dan-leo/digital-power-supply/README.md

# digital-power-supply
This is a low noise digital power supply. It is custom built for the purposes of the Electronic Design 344 course held at Stellenbosch University.
