dan-leo/digital-power-supply/wiki/Edesign344Project18361137.pdf

# 10/1/2016 Linear Power- supply Design

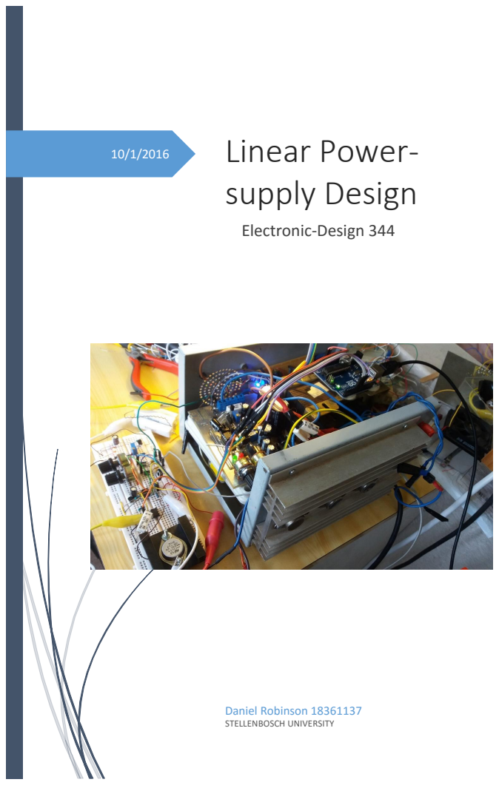
[picture p7: page 1]
Electronic-Design 344; Daniel Robinson 18361137; STELLENBOSCH UNIVERSITY

1-2

## Declaration

I, the undersigned, hereby declare that the work contained in this report is my own original work and unless otherwise stated.

Signature: |
D. Robinson
Date: |

1-3

## Abstract

This report will document the design, analysis, measurement and correlation between theoretical, simulated and measured values of a power supply which can be digitally interfaced, per desired specifications. Due to the limited time frame, and the amateur experience, it is indeed a simple power supply; also, meant to educate the designer.

The report will document all the obstacles, errors and choices made, until a relatively stable conclusion is reached, throughout the paper.

1-4

## Summary

This project was built using a huge 160W transformer in mind, but due to the large currents it damaged the PCB beyond repair within the remaining time left for the project. In fact, it was the morning of the demo that it happened. A quick simple circuit was breadboarded and demonstrated later that day. Both designs will be discussed throughout the paper.

One highlight was sourcing 19A through that 160W transformer.

This project, including report, spice code and CAD files can be found on https://github.com/daniel-leonard-robinson/digital-power-supply .

1-5

## Table of Contents

Declaration | 1-2
Abstract | 1-3
Summary | 1-4
1 | List of Abbreviations | 1-9
2 | Introduction | 2-10
3 | Problem Statement | 3-11
4 | Literature Study: System | 4-12
5 | System Design | 5-12
5.1 | Transformers | 5-12
5.1.1 | Literature Study | 5-12
5.1.2 | Design | 5-12
5.1.3 | Analysis | 5-15
5.1.4 | Building the circuit | 5-16
5.1.5 | Measurements | 5-17
5.1.6 | Comparison of theoretical and measured values | 5-17
5.1.7 | Conclusion and recommendations | 5-18
5.2 | Rectifiers & Capacitor Banks | 5-19
5.2.1 | Literature Study | 5-19
5.2.2 | Design | 5-19
5.2.3 | Analysis | 5-20
5.2.4 | Building the circuit | 5-20
5.2.5 | Measurements | 5-22
5.2.6 | Comparison of theoretical and measured values | 5-22
5.2.7 | Conclusion and recommendation | 5-23
5.3 | Zener Constant-Voltage Reference | 5-23
5.3.1 | Literature Study | 5-23

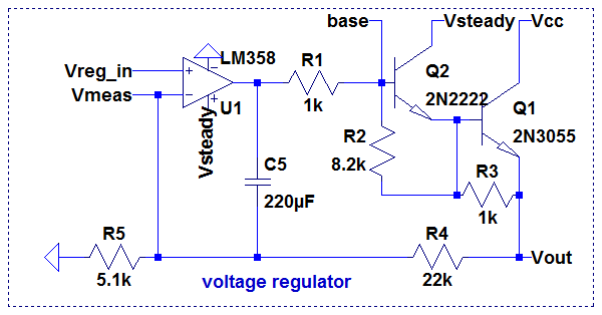
[picture p8: figure]

1-6

5.3.2 | Design | 5-24
5.3.3 | Analysis | 5-24
5.3.4 | Building the circuit | 5-25
5.3.5 | Measurements | 5-25
5.3.6 | Comparison of theoretical and measured values | 5-25
5.3.7 | Conclusion and recommendation | 5-25
Literature Study | 5-25
5.4 | Outboard Pass transistor stage | 5-25
5.4.1 | Literature Study | 5-25
5.4.2 | Design | 5-26
5.4.3 | Analysis | 5-28
5.4.4 | Building the circuit | 5-29
5.4.5 | Measurements | 5-30
5.4.6 | Comparison of theoretical and measured values | 5-30
5.4.7 | Conclusion and recommendation | 5-30
5.5 | Voltage Regulator | 5-30
5.5.1 | Literature Study | 5-30
5.5.2 | Design

5-31

5.5.3 Analysis | 5-32

1-7

5.5.4 | Building the circuit | 5-32
5.5.5 | Measurements | 5-32
5.5.6 | Comparison of theoretical and measured values | 5-33
5.5.7 | Conclusion and recommendation | 5-33
5.6 | Current limiter | 5-34
5.6.1 | Literature Study | 5-34
5.6.2 | Design | 5-34
5.6.3 | Analysis | 5-36
5.6.4 | Building the circuit | 5-36
5.6.5 | Measurements | 5-37
5.6.6 | Comparison of theoretical and measured values | 5-37
5.6.7 | Conclusion and recommendation | 5-38
6 | Circuit Integration (Analogue) | 6-39
6.1 | Final System Measurements | 6-41
6.2 | Interpretation of Results | 6-41
7 | Software Design | 7-43
7.1 | Purpose & Requirement | 7-43
7.2 | Software Literature | 7-43
7.3 | Software Development Approach | 7-44
7.4 | Instructions | 7-45
7.4.1 | Voltage Gain | 7-45
7.4.2 | Current Gain (transconductance) | 7-45
7.5 | Software Extras | 7-46
7.5.1 | Control System | 7-46
7.5.2 | Battery charging profiles | 7-47
7.5.3 | Cellular connectivity | 7-50
7.6 | Arduino Interface | 7-50
7.6.1 | Inputs (PWM RC filters) | 7-50
7.6.2 | Outputs | 7-52

1-8

7.7 | Complete System Integration (+digital) | 7-54
7.7.1 | Interpretation of results in Appendix A | 7-56
8 | Appendix A: Measured Demonstration Results | 8-56
9 | Appendix B: Circuit Diagram | 9-58
10 | Appendix C: PCB Layout | 10-60
11 | Appendix D: Photo of Circuit | 11-61
12 | Appendix E: Calculations | 12-63
12.1 | Appendix E.1: Transformers | 12-63
12.2 | Appendix E.2: Rectifiers & Capacitor Banks | 12-63
12.3 | Appendix E.3: Zener Constant Voltage Reference | 12-63
12.4 | Appendix E.4: Pass Output Stage | 12-63
12.5 | Appendix E.5: Voltage Regulator | 12-63
12.6 | Appendix E.6: Current Limiter | 12-63
12.7 | Appendix E.7: Arduino Interface | 12-63
12.7.1 PWM filter | 12-63
13 | Appendix F: Source code | 13-65
14 | Appendix G: Extra information | 14-77
14.1 | Extra Hardware Features | 14-77
14.1.1 Battery charging profiles | 14-77
15 | Final Conclusion | 15-77
16 | Figures | 16-77
17 | Glossary | 17-80
18 | Index | 18-80
19 | Bibliography | 19-81

1-9

1 | List of Abbreviations
| • PCB – Printed Circuit Board • SMPS – Switched Mode Power Supplies • NiMH – Nickel-Metal Hydride • Pb – Lead • Li – Lithium • RC – Resistor Capacitor • LPF – Low Pass Filters • PSRR - Power Supply Rejection Ratio

2-10

2 | Introduction
| The aim of this project is to build a power supply to satisfy a client’s requirements.
It must have minimal ripple, as well as constant voltage and current mode. It must also be built using analogue components such as op amps, but not ICs such as voltage regulators (e.g. LM317). There are components provided, but it is up to the designer what they use. They may use components provided by the Stellenbosch University store room, or source their own.
| The power supply is the heart of all electronic devices. An understanding is crucial
in understanding the non-linear effects, responses and ways a power supply can affect a product. Power supply design is very broad, and two directions which benefit relatively equally, albeit differently, from a project like this, are either ultra-low powered, or high powered applications.
| Lastly, there will be a limited time frame to complete this project, which simulates
industry conditions, and is mostly meant to educate the designer him/herself, by overcoming pitfalls the designer is mostly unprepared for. Such pitfalls one really only overcomes through experience, and it is a good precursor to a future in the industrial or academic world.

Design -> Analyse -> Build -> Measure -> Repeat

3-11

## 3 Problem Statement

The design of the power supply will overcome the following problems:
| • Low ripple • It is required to provide 1A at 12V • It is required to provide 500mA at 14V • It is required to measure and set voltages/currents via a PC. • (Optional) Charge NiH and Pb batteries using software profiles • The op amps can output max Vcc – 1.5V • The output stage pass transistors have a voltage drop across them (perhaps 1V). • All in all, there is about a 2-3V drop to regulate unregulated voltage after the diode bridge. • Non-linear effects of op amps, transistors, Zeners etc. must be considered

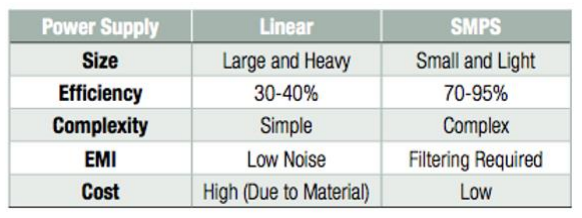
[picture p9: figure]

5-12

4 | Literature Study: System
| Power supplies are used all over the world. There are many different kinds. Besides
varying power ratings, they are divided into mainly two fields: linear and switched mode power supplies, with the latter being more complicated. A note on SMPS: due to its frequency selective behaviour in choosing output current for an arbitrary load, it is quite efficient, and requires much smaller transformers as opposed to linear power supplies.
| On the other hand, SMPS are very noisy in radio applications, and rather require
linear power supplies.

## 5 System Design

This will include the design, analysis, measurements and comparisons of theory and results as well as an introductory literature study.

5.1 | Transformers
5.1.1 | Literature Study

“Michael Bay invented transformers in 1903. “

5.1.2 Design

There are two transformers provided: a 230V primary to 15V 1A secondary transformer, as well as a dual secondary 9V 400mA transformer. There are another two transformers that the designer had available: a 16V dual secondary (unknown current rating), and a 20V 8A secondary transformer.

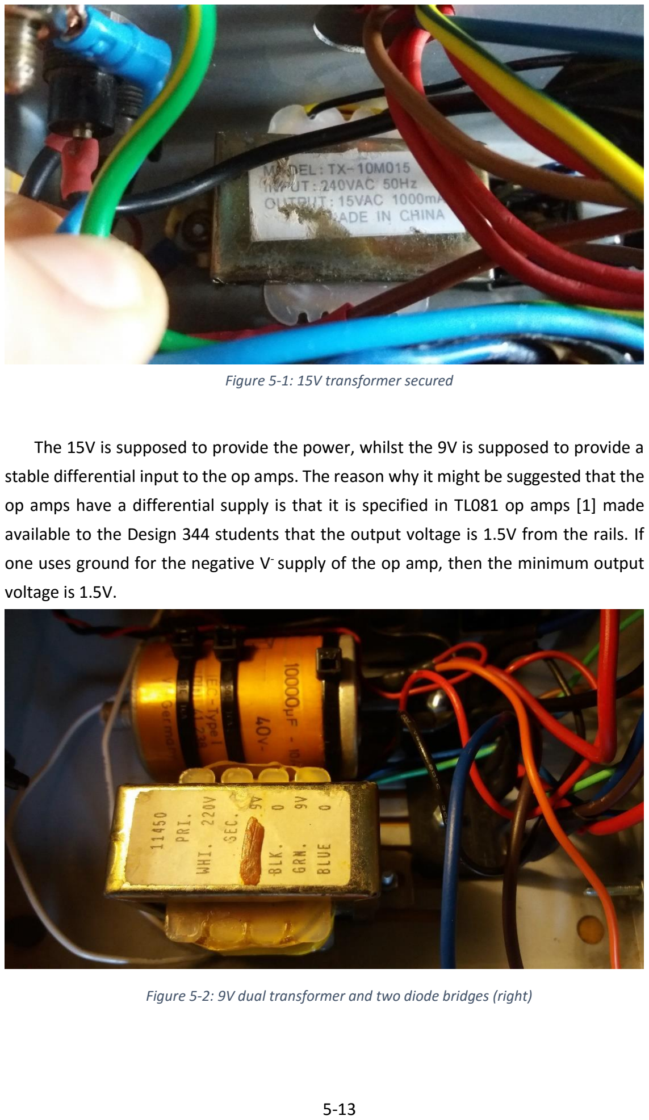
[picture p10: page 13]

5-13

Figure 5-1: 15V transformer secured

The 15V is supposed to provide the power, whilst the 9V is supposed to provide a stable differential input to the op amps. The reason why it might be suggested that the op amps have a differential supply is that it is specified in TL081 op amps [1] made available to the Design 344 students that the output voltage is 1.5V from the rails. If one uses ground for the negative V-supply of the op amp, then the minimum output voltage is 1.5V.

Figure 5-2: 9V dual transformer and two diode bridges (right)

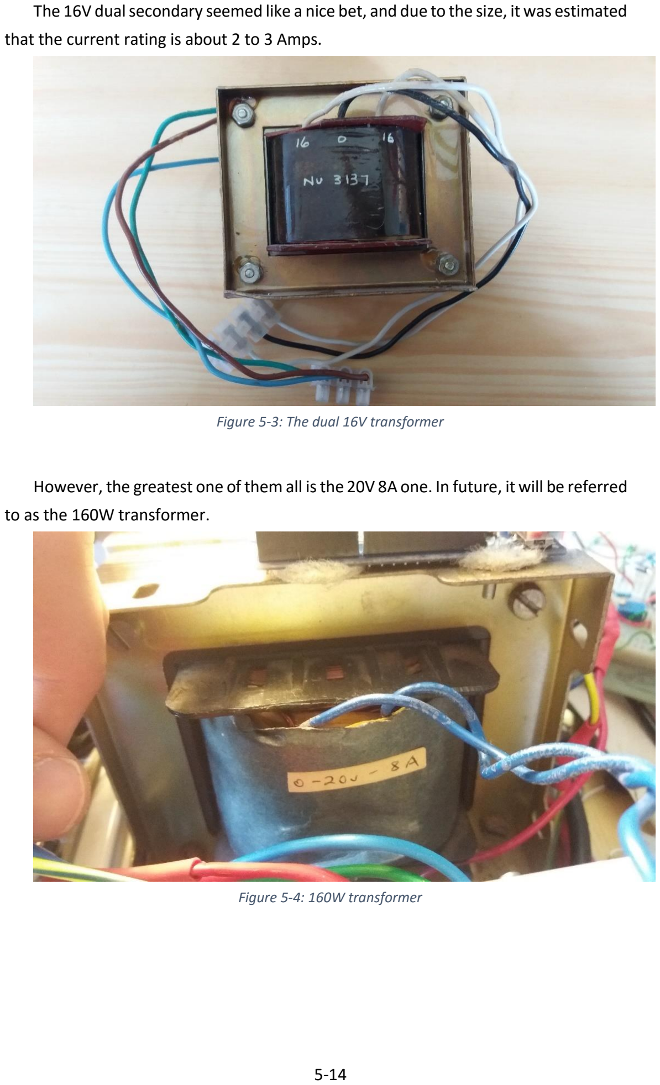
[picture p11: page 14]

5-14

The 16V dual secondary seemed like a nice bet, and due to the size, it was estimated that the current rating is about 2 to 3 Amps.

Figure 5-3: The dual 16V transformer

However, the greatest one of them all is the 20V 8A one. In future, it will be referred to as the 160W transformer.

Figure 5-4: 160W transformer

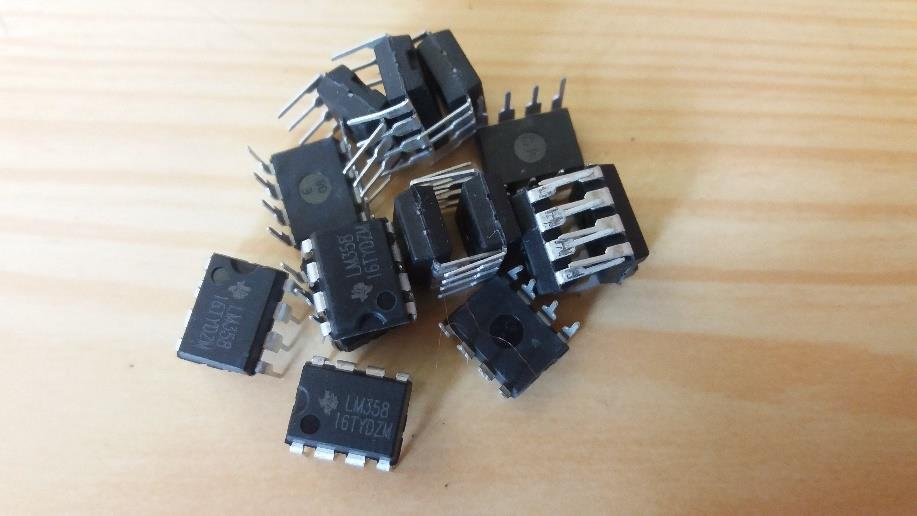
[picture p12: figure]
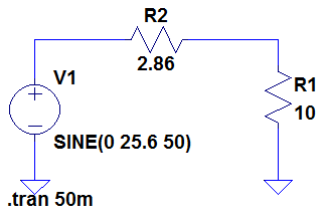
[picture p13: figure]

5-15

It was planned that dual LM358 op amps would be used since a bountiful supply was available, and they could output 0V in single rail mode ¹ when sinking low currents. The goal is just to design a power supply that requires only 1 rail to fully make use of the extra voltage overhead. Then one also only needs one transformer in the end.

Figure 5-5: Couple of dual LM358s

5.1.3 Analysis

When the 15V transformer voltages were measured under load, it was discovered that Rseries was about 2.86 ohms. See Appendix E.1
Using this information, a spice model was built to see what kind of voltages to expect under 1 Amp load.

Figure 5-6: simple thevinin equivalent 15V transformer model.

1
Single rail mode means a supply voltage of 0 to Vcc, not -Vcc/2 to Vcc/2

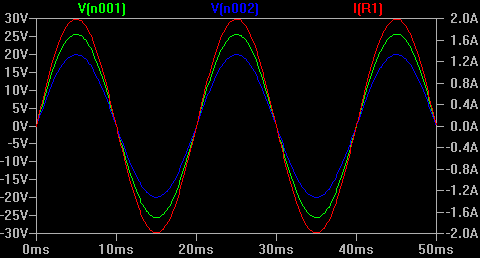
[picture p14: figure]
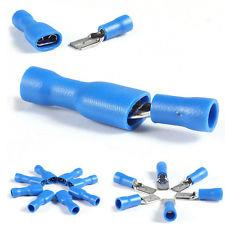
[picture p15: figure]

5-16

Figure 5-7: voltage drop after series resistance (blue), current (red)

With an average current of 1A, we can see here that the peak voltage only drops about 5V. Unfortunately this is not very helpful without the capacitive load as well, since one does not yet know by how much the voltage will drop in the end.

5.1.4 Building the circuit

Crimp connectors were used for easy “hot swapping” of transformers.

Figure 8: Crimp connectors

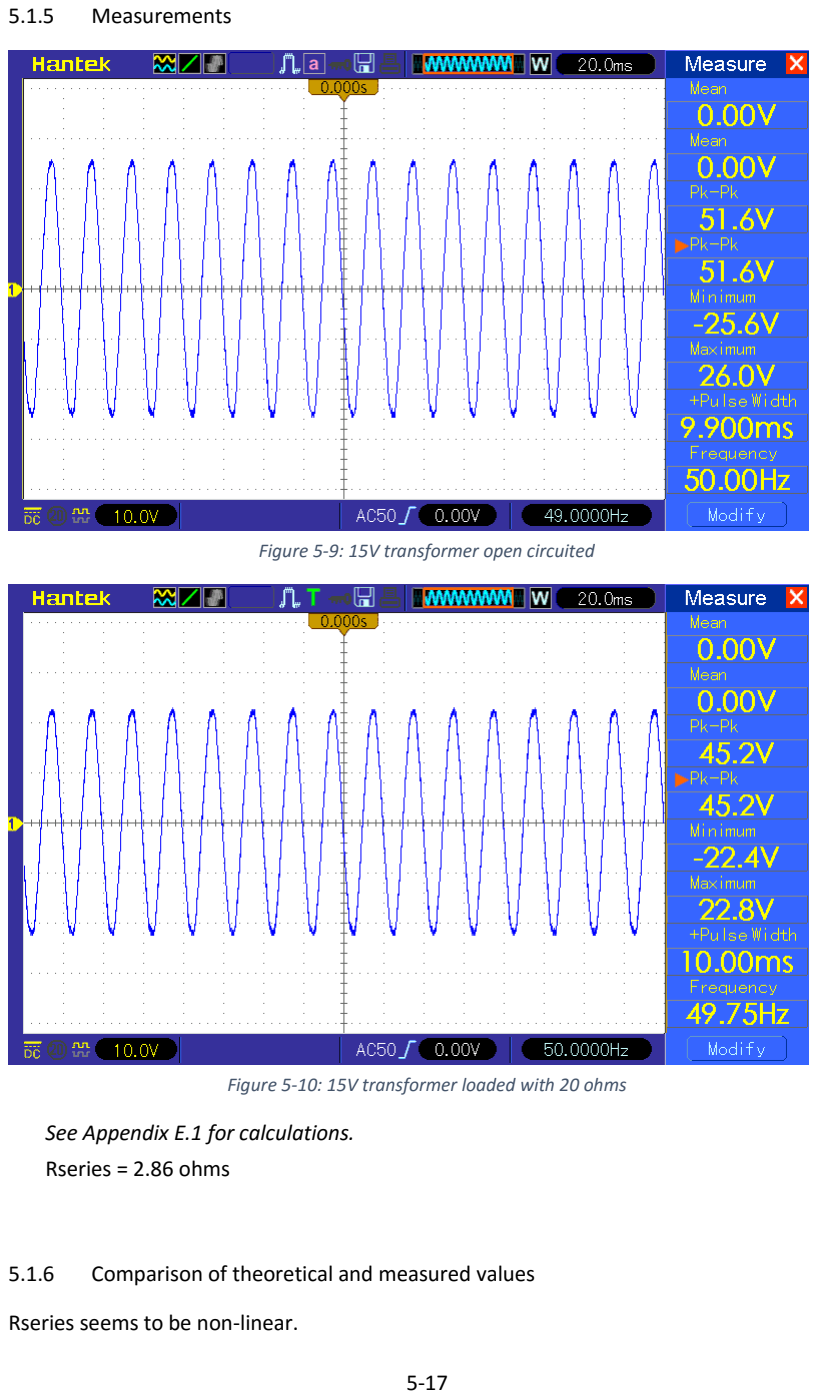
[picture p16: page 17]

5-17

5.1.5 Measurements

Figure 5-9: 15V transformer open circuited

Figure 5-10: 15V transformer loaded with 20 ohms

See Appendix E.1 for calculations. Rseries = 2.86 ohms

5.1.6 Comparison of theoretical and measured values

Rseries seems to be non-linear.

5-18

5.1.7 Conclusion and recommendations

Of course, as a recommendation is to actually use a bigger transformer. Well, the plan is indeed to be able to utilise both transformers interchancheably.


5-19

5.2 | Rectifiers & Capacitor Banks
5.2.1 | Literature Study

“Today, tomorrow, together we’ll open a capacitor bank.”

5.2.2 Design

The Taylor series approximated ripple equation gives the voltage ripple over the capacitors when the max current is flowing through the diode bridge and depends on the frequency of the mains, and the capacitance used.

| Vr =

Imax
2 ∙ f ∙ C
Two 10mF 35V capacitors were available. With Imax = 1A, f = 50Hz and C = 20mF.
| Vr = 500mV

Figure 5-11: Bridge and capacitors

A steadier voltage reference was used to supply power to everything except the pass transistor. With the estimated power usage to be about 100mA, the steadier voltage supply would have about 50mV of ripple. Besides current not being able to escape through the blocking diode, it is steadier because less current discharges out of the capacitors, and relates to the equation:
dv
dt = i
C

⁄

With less current, and more capacitance, the change in voltage is less.

Luckily, the whole purpose of a voltage regulator is to regulate the input. Therefore, the op amp can compensate for this lesser ripple by having a stable Zener reference.

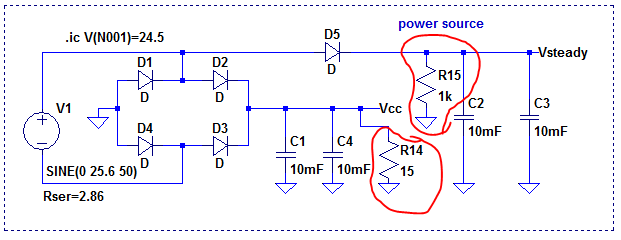
[picture p17: figure]
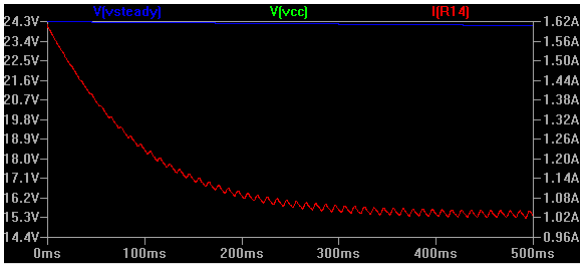
[picture p18: figure]

5-20

5.2.3 Analysis

Here is a circuit to display the two different voltages that will be used to power the circuit.

Figure 5-12: 15 ohm load, and 1k represents the load of the rest of circuit

Figure 5-13: Diode + capacitor bank under load.

It appears to be a neat trick. The voltage tapped off before the diode bridge seems to be much higher than the voltage used to power the load.

5.2.4 Building the circuit

The circuit was built with a diode bridge which accepts crimp connectors. This means that hotswapping a transformer is very quick, easy, and requires no soldering.

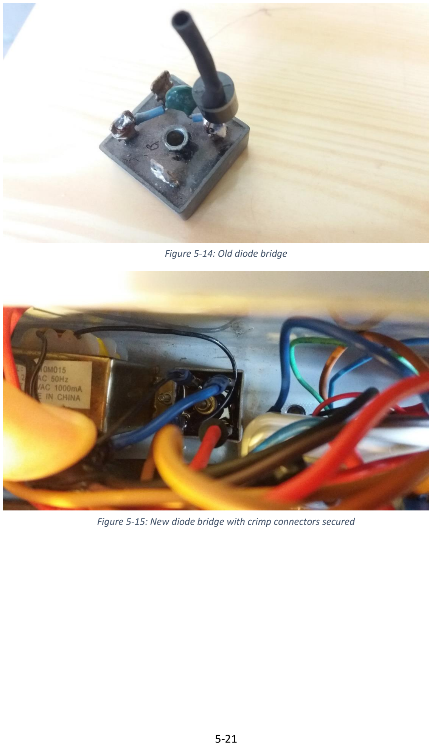
[picture p19: page 21]

5-21

Figure 5-14: Old diode bridge

Figure 5-15: New diode bridge with crimp connectors secured

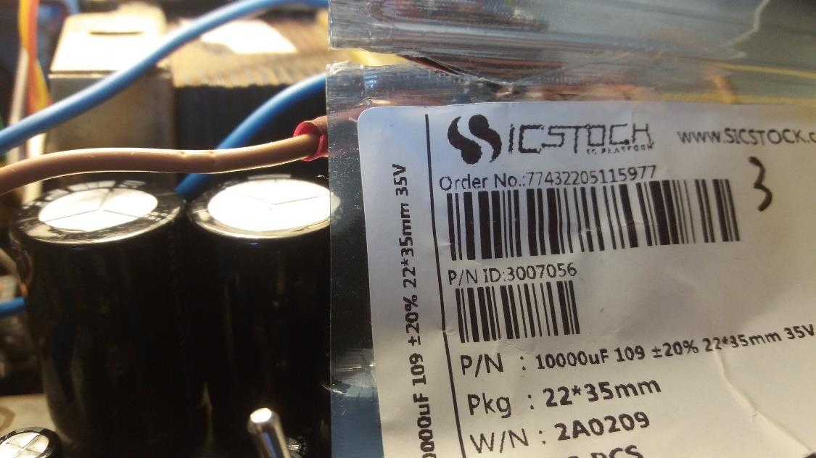
[picture p20: figure]

5-22

Figure 5-16: 10 mF capacitor bank

5.2.5 Measurements

The 160W transformer drops about 1V per 1A that is drawn. It is 30V unloaded, and fits within the max power supply rating for the LM358 [1] being 32V. Rseries was also calculated to be below 0.1 ohm.

Under 1Amp load, the Vsteady is 13.7V and Vcc is 13.0V.

5.2.6 Comparison of theoretical and measured values

With Vcc being 13V and Vsteady being 13.7V, the neat trick in 5.2.3 does not appear to work. This is because the ‘steady’ voltage eventually discharges.

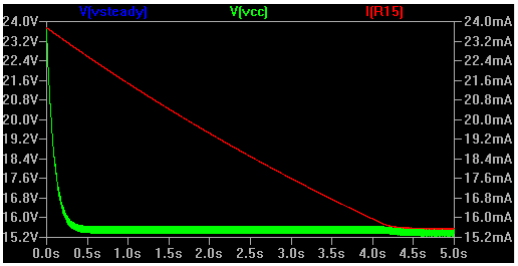
[picture p21: figure]

5-23

Figure 5-17: steady voltage over time

See how Vsteady and Vcc end up being 0.7V apart. This was the voltage used for the demo, and would explain a few discrepancies which will be mentioned later on.

5.2.7 Conclusion and recommendation

A separate transformer would indeed have kept Vsteady much higher. One solution would be to use one of the 9V transformers as a voltage doubler, and to use an 18V Zener (with transistor) to power the op amps and the rest of the circuit.

5.3 | Zener Constant-Voltage Reference
5.3.1 | Literature Study

“Zeners make great fireworks.”

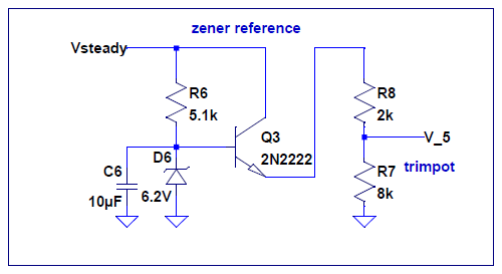
[picture p22: figure]
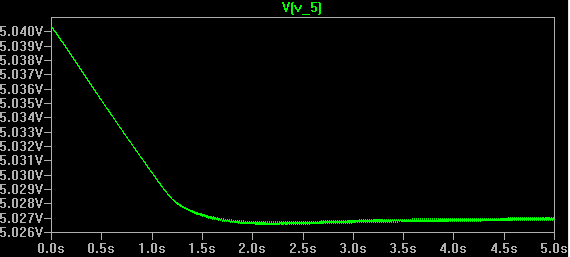
[picture p23: figure]

5-24

5.3.2 Design

Figure 5-18: Zener reference circuit

The Zener is biased in the linear region. See appendix for Calculations. C6 is used to stabilise the Zener reference somewhat. Since the transistor draws much less current than the trim pot, it avoids additional potentiometers drawing too much current from the Zener biasing resistor, which, by creating too great a voltage drop across it, would extend under the operating voltage of the Zener, and thus create a mere voltage divider. The trim pot is tweaked to obtain an exact 5V reference. By doing so, one matches with the domain of the Arduino, and thus simplifies relevant calculations. Details are documented in Appendix G.

5.3.3 Analysis

Figure 5-19: Zener circuit tuned output

5-25

The ripple, according to spice, is 187uV.

5.3.4 Building the circuit

Building the reference was relatively straightforward.

5.3.5 Measurements

The tuned Zener output is exactly 5V. The ripple is too small to measure on a scope, even on 2mV per division.

5.3.6 Comparison of theoretical and measured values

There is negligible difference. Ripple too small to measure.

5.3.7 Conclusion and recommendation

The Zener reference is easy to build, especially since it can be tweaked.

There exists an internal 1.1V Zener reference, which should allow more accuracy should it be accounted for in the design of the system. Although it requires two extra op amps to scale the 5V compatible ADC readings down to 1.1V, it means that there does not need to be an 8-12V external supply to the Arduino to power the 5V Zener, which satisfies this design. In the end, powering the 5V Zener is inevitable, since the platform is easily scalable, one might want to add extra features requiring processing power from the microcontroller. See extra features in Appendix G.

Literature Study

5.4 | Outboard Pass transistor stage
5.4.1 | Literature Study

“Passing engineering is mandatory”.

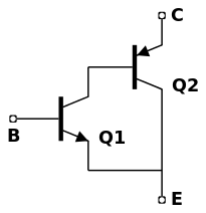
[picture p24: figure]
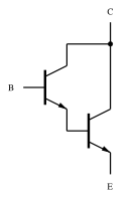
[picture p25: figure]

5-26

Figure 5-20: Sziklai pair

The Sziklai pair [2] was considered, however not used since the op amps could only output up to V⁺ – 1.5. To turn off the transistors completely, one needs to match the voltage of the base of Q1 in Figure 5-4 to the collector of Q2. In the ideal sense, it would have a lower Vce drop as opposed to the Darlington pair.

Figure 5-21: Darlington pair

The Darlington pair was considered since it can be fully turned off. It has a larger collector-emitter voltage drop, however.

5.4.2 Design

It was decided to use 2N3055 power transistors [3] as they are more easily mounted on a heatsink, compared to the TO-220. Besides that, they absorb more heat.

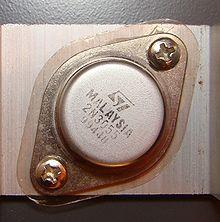
[picture p26: figure]
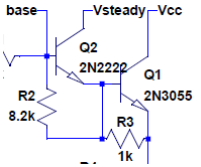
[picture p27: figure]

5-27

Figure 5-22: 2N3055 transistor

Lastly, it was decided that the whole circuit be powered by a steady voltage source, and that most of the power for the load would be provided solely to the collector of the Darlington pair. This way the system would work in true regulator fashion.

Figure 5-23: Final pass transistor output stage design

As shown in Fig 5-6, the collector is powered separately to the rest of the circuit.

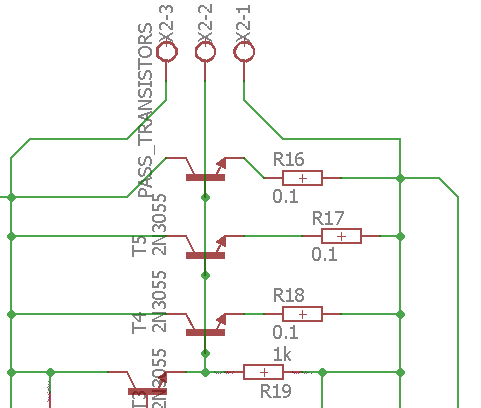
[picture p28: figure]
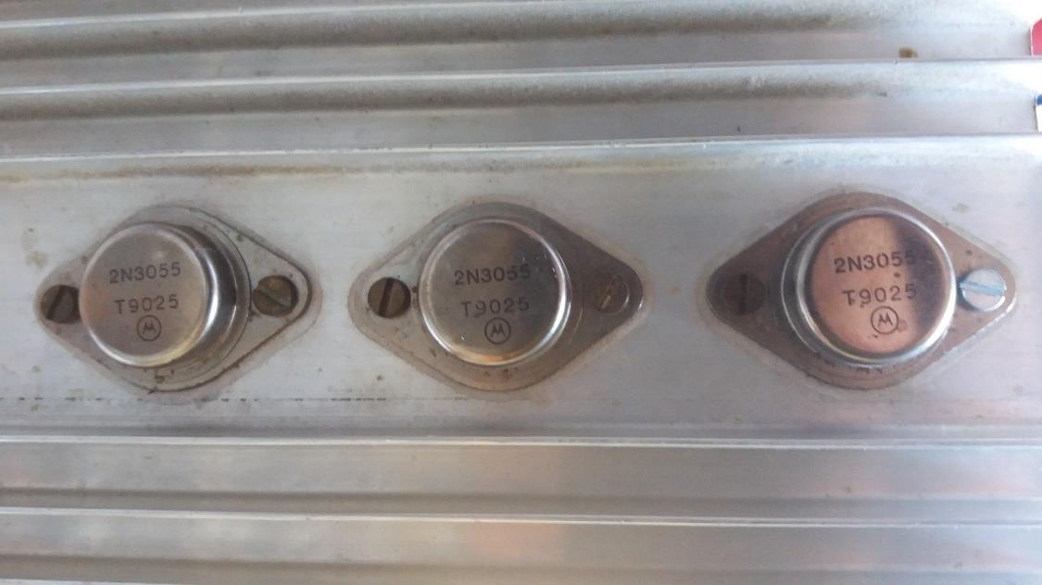
[picture p29: figure]

5-28

Figure 5-24: Three outboard pass transistor output stage

Outboard pass transistors are easily scalable, and one can add as many transistors as deemed necessary to dissipate heat. The emitter resistor is required to prevent thermal runaway [4].

Figure 5-25: Outboard pass transistors to be used in design

5.4.3 Analysis

The biggest question here is whether the op amp will be able to supply enough current to the Darlington pair.

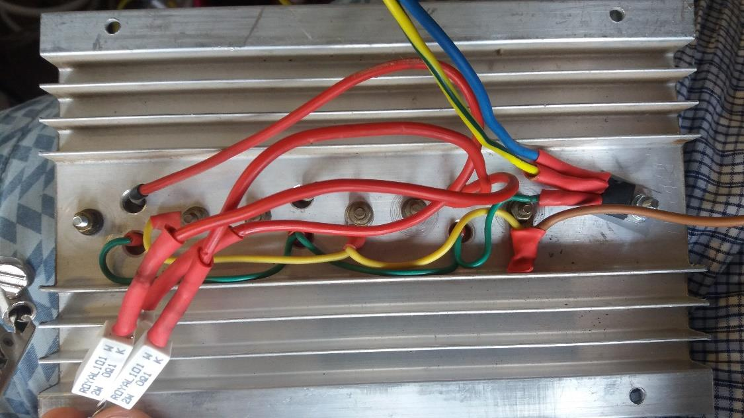
[picture p30: figure]

5-29

Assuming 1A flowing through the 2N3055, and with a beta or hfe between 20 and 70 [3] we can assume it is about 50. That means a base current of 20mA. The pre-driver should be more than capable of providing that. Per the 2N2222 datasheet [5], it has a beta value of about 100 under optimal conditions. Therefore, the base current is 200uA. The op amp can provide typically 40mA, therefore the requirement is more than satisfied. Calculating currents when adding multiple outboard pass transistors is simple: merely divide the base and collector currents by the number of such transistors.

Next question is whether the heatsink will handle the current. See Appendix E.4 for calculations.
The heatsink can handle 47.05 W power at 25 degrees, which is more than 12W, but not more than 160W from the secondary transformer.

5.4.4 Building the circuit

When the heatsink was built for the 160W transformer, a TIP41C [6] was also used to power the three 2N3055s.

Figure 5-26: 2N3055 Heatsink

Notice the thermal runaway protection resistors connected to each emitter (white).

The TIP41C ensured that, especially in the case of drawing 19A, that it would source 19/50 = 380mA, and the 2N2222 would draw 3.8mA. The base current of that 2N2222 is now 38uA. It may be thought that this is overkill, but the 2N2222 would get a bit hot if it drew 380mA. This is assuming a beta of 50 for both the TIP41C and the 2N3055,

5-30

and 100 for the 2N2222. But for the purposes of this paper, it need not be mentioned any further.

5.4.5 Measurements

Under 1Amp load, the Vsteady is 13.7V and Vcc is 13.0V.
The base of the 2N3055 is 10.900V, the collector matches Vcc and the emitter is 10.1V. The base of the pre-driver 2N2222 is 11.5V. The voltage across the 1k protection resistor is 87mV. That means 87uA is going into the base of the pre-driver.

5.4.6 Comparison of theoretical and measured values

In the previous section we found out that the base is using 87uA, which is within the range estimated in 5.4.3 being between 38uA and 200uA. 87uA is also very tiny compared to the amount that the op amp can supply, being typically 40mA [1].

5.4.7 Conclusion and recommendation

The outboard pass transistors are satisfactory. The heatsink does not actually seem satisfactory, therefore it will be considered to use large currents in pulse charging only.

5.5 | Voltage Regulator
5.5.1 | Literature Study

“Regulations are a chore.”
Voltage regulators are used in many applications, from power generation, automotive, aerospace down to micro-electronics. It provides a steady power source for sensitive electronics; especially since smoothing capacitors are bulky and expensive, it does not make sense to put such things on small PCBs.

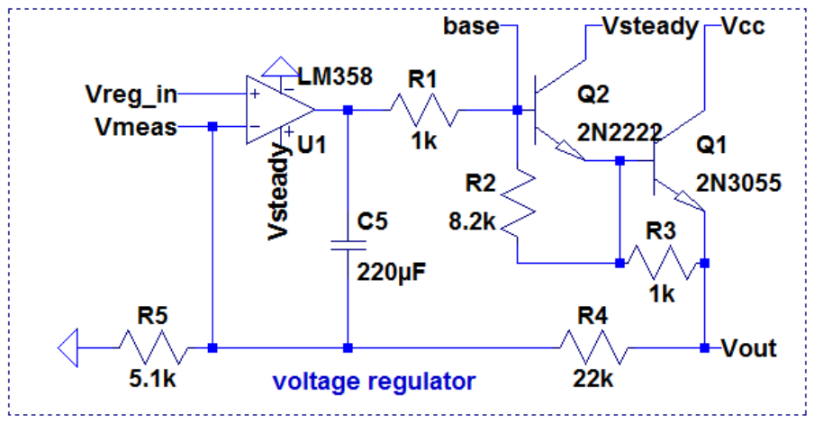
[picture p31: figure]
Design

5-31

Figure 5-27: Voltage regulator

Here is the voltage regulator. Since we know that the base current of the pre-driver is about 38 to 200uA, the voltage drop across R1 is about 3.8 to 200mV. This means that in the worst case scenario, the maximum output voltage is as follows:
Since the transformer drops to about 16V under a 1A load (including capacitors), the op amp can output a max of Vsteady-1.5V. Assuming that Vsteady and Vcc is the same. Therefore, the op amp outputs about 14.5V. With a further drop of 200mV, it is 14.3V at the base of the pre-driver. Assuming a drop of 0.6V across Vbe of the pre-driver, and 0.7V across the pass transistor(s), we finally have a max output voltage of 14.3-0.6-0.7=12V. This satisfies the minimum requirements.
R2 and R3 are for more stability due to the differing capacitances in the different driver stages.

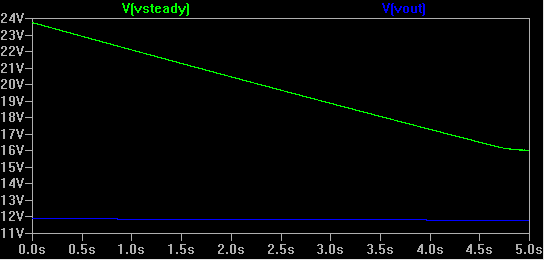
[picture p32: figure]

5-32

5.5.3 Analysis

Figure 5-28: Output voltage at 12V (blue), op amp steadies at 16V

In this picture, a 12 ohm load was connected to the output. Even though the Vsteady smoothing capacitors discharged from 24V to about 16V, the output still maintained 12V.

5.5.4 Building the circuit

Originally R4 and R5 had much larger values. We’re talking 27k and 135k. Although it is also a gain of about 6, the current through it was not sufficient to actually output any voltage. Lowering the values (keeping the ratio) fixed the problem.

5.5.5 Measurements

Under 1Amp load, the Vsteady is 13.7V and Vcc is 13.0V. The reason for this is probably due to a non-linear internal resistance (affected by temperature as well as current). The base of the 2N3055 is 10.900V, the collector matches Vcc and the emitter is 10.1V. The base of the pre-driver 2N2222 is 11.5V. The voltage across the 1k protection resistor is 87mV. That means 87uA is going into the base of the pre-driver. This was also found out in 5.4.5.
This means that the op amp is outputting roughly 11.5V.

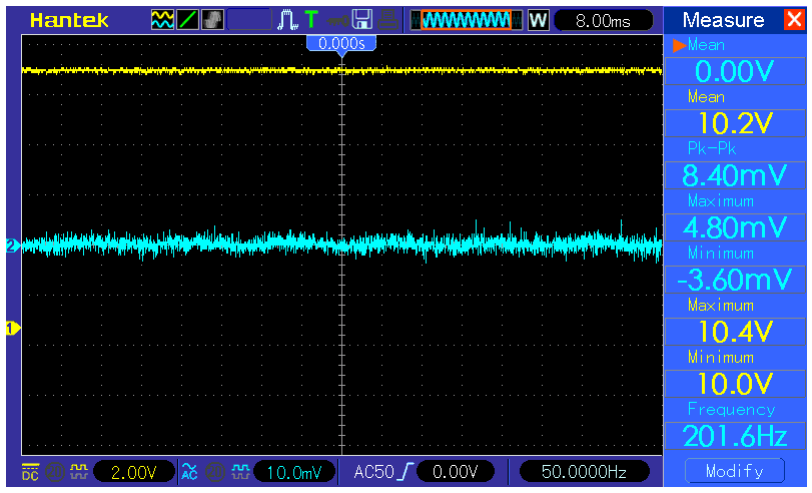
[picture p33: figure]

5-33

Figure 5-29: 10 ohm load, constant voltage, ripple negligible

In the previous figure we can see that ripple is non-existant, and that the voltage is steady. This includes the voltage over Rsense (0.1V), and it seems that at this resolution and voltage, it shows voltages in steps of 0.2V.

5.5.6 Comparison of theoretical and measured values.

If we had an 18V supply for the op amps, then the max voltage would seem to be, according to measured values, 18 – Vrail-limit – VBE_driver – VBE_pre-driver – VR_sense = 18 – 1.5 – 0.8 – 0.6 - 0.1= 14V

5.5.7 Conclusion and recommendation

The op amp output, being 11.5V, is 2.2V under 13.7V, which means there is still headroom for more voltage, but not enough that the output voltage will reach 12V under a 1A load. This can easily be rectified, as mentioned in 5.2.7 by having a voltage doubler and a second transformer. In fact, it may even be rectified using the same transformer, but it will need to be investigated.

All in all, with such negligible ripple, the designer is satisfied that the Zener is indeed stable enough that the op amp compensates for the 50Hz ripple that the smoothing capacitors cannot fully straighten out.

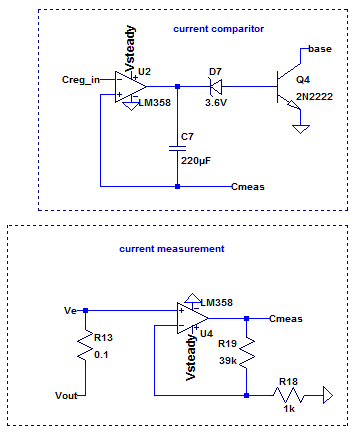
[picture p34: figure]

5-34

5.6 | Current limiter
5.6.1 | Literature Study

“Limiting ones imagination is limiting one’s life!”.
Current limiters are handy to protect external circuits from current surges, shorts, or merely too much current. They protect the power supply as well.

5.6.2 Design

Figure 5-30: current comparitor and measurement

The current controlling consists of pulling the base voltage of the Darlington pair down to ground. This controls the voltage, which ultimately controls the current.
It was noticed that the comparator could not output a voltage lower than about 3V, so a 3.6V Zener was used to turn off Q4, otherwise the circuit was in current limiting mode when it was suppose to be in constant voltage mode.

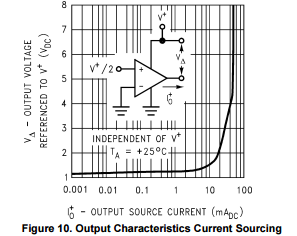
[picture p35: figure]

5-35

This fact can be verified when looking in the datasheet [1],

Figure 5-31: Output characteristics of LM358

That sourcing about 30mA would in fact mean that indeed the lowest output voltage is about 3V. The large current can be attributed to the large capacitive load that it also has to drive.

The large value of C7, 220uF, is used to slow the comparator down. It is basically a large integrator. This means that the steady state error is very low, however, there is overshoot on unit steps such as connecting a load. It also removed oscillations. At least, for functional demonstration purposes, it was satisfactory.

As mentioned in 7.4.2, the measurement op amp merely provides a gain of 40 to the voltage across Rsense. The max voltage across Rsense is 100mV. Therefore, the max voltage that the measurement op amp will provide is 4V. This is within the 5V specifications.

The transconductance of the comparator is theoretically 0.25, since 4V is equal to 1A, then 0.25*Vpot_base = 1A.

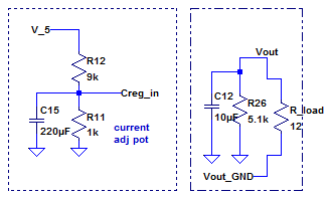
[picture p36: figure]
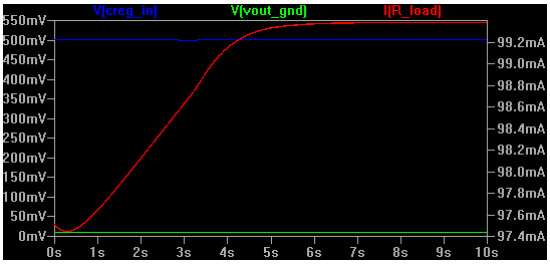
[picture p37: figure]

5-36

5.6.3 Analysis

Figure 5-32: Current limiter set up to limit 100mA

Figure 5-33: Current limiter in action limiting 100mA (red)

5.6.4 Building the circuit

Much trouble with oscillations was found until less than a week before the final demonstration. A large component of time was spent solving the problem in spice. Spice broke easily, however, and became a tradeoff between speed and accuracy. The solution, well, at least a solution, was discovered almost by accident. By placing capacitors in different places on the actual circuit, it was discovered that the large capacitor attached to the output of the comparator solved most of the problems. Besides the experience garnered from spice, the idea of creating variations of integrators, and LPFs was in mind when solving the problem. Its not a final solution, however. Yes it may be stable, however, there is overshoot when attaching a load, and that would need to be fixed in future.

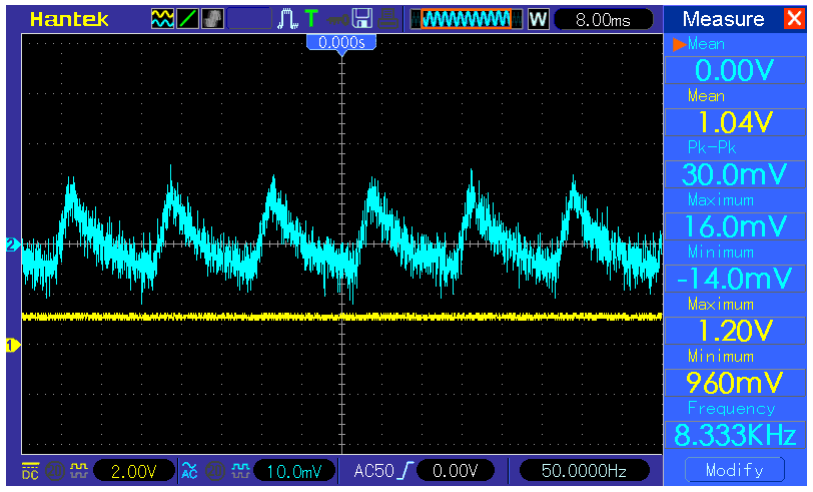
[picture p38: figure]

5-37

Lastly, the 39k was replaced with an 18k while building, since the gain was too much otherwise. It is something to be investigated in future. Another reason was that it was too sensitive to changes. Changing the current potentiomter gave a digital square wave / unit step kind of change.

5.6.5 Measurements

Figure 5-34: Current limiting at 100mA, 30mVp-p

Current limiting seems to work, with satisfaction.

The value at the base of the current adjust potentiometer is 167mV. This means a ratio of exactly 0.6²

5.6.6 Comparison of theoretical and measured values

The gain of the current op amp is about 19, instead of 40. If it were 40, then the transconductance would be 0.25, as mentioned in 5.6.2. Since it is now 19, the transconductance is roughly double that, being 0.5, or to be precise 0.53. This is relatively close to 0.6 in reality, and can be put down to tolerances and non-linear effects of the op amp.

Differences are also due to ground feedback!

2 0.6*value at base of potentiomer is current; hench transconductance.

5-38

5.6.7 Conclusion and recommendation

As mentioned in 5.6.4, it would be ideal to have a fast current limiter, that does not have any overshoot when connecting a load. This could otherwise have disasterous implications during short conditions, and it is believed that this is one of the reasons the PCB that had been made stopped working at all. Oscillations are not easy to expel, and a conscientious effort should be made over the long term to dispel any cause of oscillations.

6-39

## 6 Circuit Integration (Analogue)

Just a few final notes here since it will take too long to discuss anywhere else: there was a noticeable sound of ringing in the PCB when in current limiting. This did not happen when connected to a lab power supply. It was concluded that, although op amps try to reject power supply ripple, it is not total, as evident in the PSRR³
. Also, the PCB did
work, but it required a negative rail for the diode method of current limiting. In fact, the diode was connected before the voltage regulator, in order to use the voltage regulator it self to help current limit. It worked very well, but I fear it may have contributed to the ringing. Before the diode method PCB worked, it had two separate ground planes. Since it did not work, and the confusion was too much, it was joined to form 1 single ground plane, and Rsense was shuffled around to provide high side extended common-mode current sensing. Much time was spent on this method of current sensing, until it was realised during the afternoon of the demonstrations that it has a crucial flaw. Besides leaking power into Vout, it also does not work with low currents and/or shorts. Funny enough, it did work well on the PCB on one stage, but it doesn’t seem to be as foolproof as previously thought.
Anyway, there was a big problem with the diode method idea. As well as it worked, the op amp supply could only go up to 16V and -16V. It was after all the dream to be able to utilise the big 160W transformer. So, two nights before the demo, after trying out nmos, pmos, npn, pnp, and even sziklai methods of current limiting at the base of the Darlington pair; it was settled upon to use the Zener and npn transistor idea. It worked well, but only after using that 220uF capacitor to stabilise the comparator. Finally, the negative rail was also joined to the ground rail. This meant that the op amps could finally have a supply of up to 32V with respect to ground. The day before the demo, the heatsink was wired up, and the 160W transformer connected. It was magic, to say the least. The ripple was in fact about 2mV.

3 Power Supply Rejection Ratio

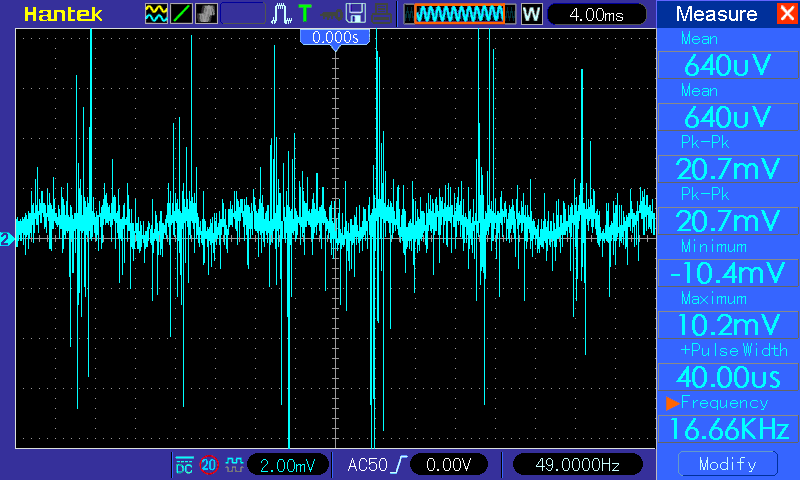
[picture p39: figure]

6-40

Figure 6-1: One favourite picture, 2mV ripple under 1A load.

At this stage, the current limiter couldn’t actually go higher than 1A. So, I soldered a jumper and a resistor to quickly switch between a 1A or 20A limit. Thereafter I only had a multimeter, and was merely testing out the capabilities of the power supply. The best moment was cranking up the power supply to 19A over a 1 ohm load. I remember that while cranking the current up, at one point when it reached 6Amps, it cut out and went down to 0. I never really found out what happened. The rest of the night was spent swapping out op amps, twisting pins, and debugging, until in the morning I had gotten it to a rudimentary condition, except I couldn’t get the output voltage to go down to 0. Rather, it went down to 0.7V. Unbeknownst to me at that moment, the voltage was leaking from the current measuring circuit. I replicated that leakage voltage when breadboarding a new circuit later that day, and realised that it was the extended common-mode current sensing configuration that was the culprit. I promptly switched to low-side current sensing, and then everything worked as expected. Of course, in the final demo, nothing was as perfect, and there were large 100mV oscillations at times, but the designer was happy to have demoed at all.

For fear of confusing the reader, there are too many stages, fixes and things to discuss about the PCB circuit, but much was learnt, and an even better one will be designed in future.

6-41

6.1 Final System Measurements

Refer to Appendix A for the final measured demonstration results. The power supply had its functionality officially demonstrated in a lab to facilitate non-fabricated readings, and to learn the nature of the power supply.

The designer must interpret the results.

6.2 Interpretation of Results

The readings were done on two channels, and both of which were attached to the output load. The one channel was 5V/div DC coupling and the other was 20mV/div with AC coupling. Unfortunately, poor quality scope leads were used (susceptible to noise), and 5V per division shows low resolution for smaller voltages.

There is no need to prove the inaccuracy as the reader should already be well aware of the general resolution of oscilloscopes.

The circuit went down to 0.0V and up to 16V under no-load conditions. The reason why the output voltage is so high is due to the transformer voltage sitting higher at no load as well. About 20V it is, and a quick thumbsuck says that the output voltage will be 3-4V less than that.

In row 3 to 5 we notice that the voltage drops when attaching a load. This is most probably attributed to the fact that there is not a separate power supply for Vsteady. Both Vcc and Vsteady drop, meaning that even the Zener value drops. Since this is the case, we can safely assume that that is why Vout drops as well. Solution is to use the 9V transformer as a voltage doubler, and use an 18V Zener, or a combination of an 11V and a 5.6V Zener to make 16.6V. That Zener would pass through a transistor and serve mainly as the op amp supply, as well as the reference and other peripherals. In fact, since the op amps could now take 32V, a Zener was not anymore necessary, since the voltage doubler would output about 26V⁴

The higher amount of ripple we see in row 5 can also be attributed to no capacitors on the middle pin of the current adjust potentiometer itself. The reason it helps is that the capacitor connected across the comparator will take current from the capacitor first mentioned, instead of the Zener reference, and ultimately causing a ripple of positive feedback for the voltage regulator.

In the 7th line we see that the voltage over the 1.1 ohm resistor is 3.6V, instead of 1.1V, as it is supposed to be limiting it to 1A. This means that over 3A was flowing. The

4 26V, because previously I had connected the 9V transformers to the op amps to get +-13V.

6-42

current limiting seem to be non-linear anyway. Too short a time-frame to work out why.

7-43

7 | Software Design
7.1 | Purpose & Requirement

The software interface is required to measure and control the output voltages and currents. As mentioned in 7.3, it is also a platform to add extra functionality. For example, charging batteries.

It is also to help students to develop code in teams using version control software such as git.

| The project required software that could run on a PC to send commands to, and
read measurement data from an Arduino via a serial interface. The firmware for the Arduino had already been written.
| The software would be a GUI, in which the user can connect to the appropriate
COM port, choose whether to stream the measurements, be shown the measured voltage and current every 200ms, set the voltage output & current limit, calibrate the system, and also send miscellaneous serial commands.
| The software was required to be stable, and user-friendly.
7.2 | Software Literature

When developing software in industry, it is good practise to create unit tests
first before developing actual source code. This works very well, but not in all cases. For example, the designer has worked at a company where he had to, initially, fix all their broken unit tests. He has worked in the firmware / embedded side of things, with well in excess of a few 100k lines of code. The reason they broke was due to fixes on the source code side of things, but with developers not having time to fix the unit tests. It was under the impression that unit tests were handy to
start off a module of code, for example, handling gps data, but later easier to test on a prototype device, especially when memory handling is an issue.
How could unittests be helpful? In the ideal sense, it is especially helpful in a
teamwork environment. For example, when one is a new recruit, there are no
docs yet and one doesn’t understand how the project works, it’s helpful to start at the unit tests, to see what to expect. Even when the project is
completed and an outsider wants to add a new feature, the project leader would want to use unit tests to test their feature to see if it is indeed compatible with their product. Regarding code reviews, one first needs to pass all the unit tests as a base starting point, before one can review code changes, diffs etc. Testing levels? There is such a thing as white box and black box testing. White box merely
tests empty functions at the very least, and how parameters are passed ~ it
smooths out errors in calling functions etc. Black box tests will actually test the product in a production environment and simulate reallife conditions, to smooth out

7-44

any errors that one might only find on the field,
as recalling products is extremely expensive. It does help, somewhat, if one can push updates to devices remotely. Of course one can release updated versions of products.

Basically, unit tests are handy to use in conjunction with version control, so that when a new member wants to push changes, or apply for a pull request, a moderator / the owner can run all the unittests on it first, before pushing to master.

Git is a fantastic tool when collaborating on a project, or even just working by oneself. It takes snapshots of code, amongst other things, in time.
What is git version control? It is a method of storing and retrieving different versions of code. It is very handy to see what caused a bug and how a certain bug has progressed. One can also use it especially to streamline workflows in collaboration.
When working on one’s own, it is helpful to go back in time to see if a bug was caused by code or external factors like hardware, especially in embedded development.
When working as a team, I think that a nice workflow is that team members work on separate branches of features that they would like to add to the master branch, and that the master branch is the main production line of code. Perhaps, after one member has completed a feature on a branch, the master branch is ahead with many commits from other features. One merely has to merge the new changes from the master branch into one’s feature branch, check that it all works (especially using unit tests), and then push to the master branch. It’s brilliant.

Lastly, I used the unit tests to develop some features. I don’t think anyone else did. It saves time to process raw data instantly, instead of having to run in on your production device (which means setting it up every time).

7.3 Software Development Approach

A team was created on BitBucket, rdb@sun.ac.za was invited and a new repository was created. The idea was to use separate branches for individual work, and one branch (master) for final project. Best of each module was to be used (work modularly). We differentiated between forks and branches. We discussed working on different parts of the project and combining the modular parts. Jean and Karlien worked together and Tristan and Daniel worked together due to close proximity. The idea was also to document the work to make it easy for other parts of the group to implement. Clear specifications and commenting convention was required.

The software interface used the pre-calculated voltage gain and transconductance to work out a formula of which it would output the required voltage / current in

7-45

the end. It could also use a control system, but that was still in my branch, and not yet merged with the rest of the code.

The software was, in fact, developed with everyone pushing and pulling to the master.

7.4 Instructions

These are instructions for getting your new power supply connected to the software interface.
This assumes that you have already connected up your Arduino as per the instructions available.
One needs to zero both the current and voltage measurements by connecting both to, ultimately 0V and 0A respectively. Then press the calibrate voltage/current zero button as appropriate. Then, set your current and voltage to a known value and use calibrate other to calibrate to those specific values. It is actually very easy to understand, and a mere two minutes playing with it will show more understanding than someone explaining in double the time.

Knowing the exact gain is useful to calibrate the software interface for setting voltages and currents. The interface needs to know what voltage out of the PWM RC filter will result in the desired output. To be specific, there are two text fields for that information. The exact gain can be different due to ground feedback (mentioned in 5.3.3), especially when measuring currents at the preamplification stage. Here are at least two methods to determine it.

7.4.1 Voltage Gain

To determine the voltage gain of the regulator, a multimeter is required. Since it was mentioned in 5.3.2 Zener Design that we should match the voltage domain of the Arduino, we can utilise the full 5V range from the Arduino (determined by PWM and RC filter, and ultimately frequency), which is as accurate as one can get.

To determine the voltage gain, set the middle pin of the voltage pot to 1V, and measure the output voltage. The output voltage will match the voltage gain.

7.4.2 Current Gain (transconductance)

A similar method as described in 14.1 can be used to determine the exact current gain. Measure 1V on the middle pin of the current adjust potentiometer with a known load 10 ohms or higher, and measure the output voltage to determine the output current.

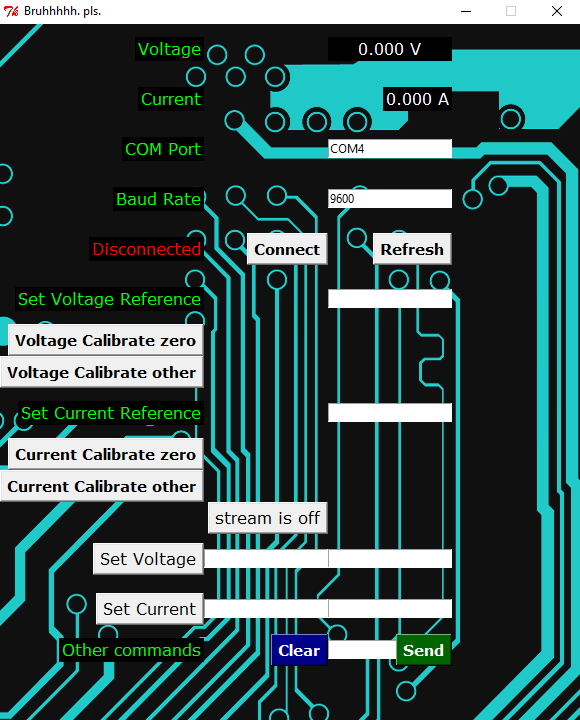
[picture p40: figure]

7-46

Figure 7-1: Software interface

7.5 | Software Extras
7.5.1 | Control System

A control system was added. Alas, it was not yet merged with the final version at the time of the demo. However, it can still be discussed, here.

7-47

The idea was to learn the plant transfer function characteristics of the power supply, without knowing the gain of the voltage regulator or transconductance3 of the current regulator.

It could be described as a PI control system.

Using a known load is preferable, as one can set appropriate step inputs to learn the system.

Let’s assume the case where a 10 ohm calibration load is used.

It gave a step input of a supposed 1000mV, and current greater than 1A. This could be adjusted by the user. Then it would take the average of several voltage measurements.

The user has the option of setting the number of samples before adjusting the output. Samples were sent every 200ms, therefore a good number of samples to test it would be about 5 samples, which means one sees a change every second. It had a slight bit of overshoot as it learned, but it would reach a steady state after about 2-3 seconds.

Upon reaching a steady state within 10% for at least 3 samples, it lowered the current to a specified value, and increased the voltage. For example, voltage now becomes 10V and current becomes 100mA. It learns what the transconductance is.

Upon learning the characteristic plant transfer function of the power supply, it made the voltage gain and transconductance less susceptible to supposed changes in future. This allowed for a smoother steady state, and less overshoot.

7.5.2 Battery charging profiles

The idea is to be able to easily add a battery charging profile to the software interface and to charge batteries such as NiMH, Pb and Li batteries⁵

To do that one needs to be able to identify the battery. Of course, one can measure the voltage of the battery. For example, a Li cell is usually between 3.7V and 4.2V, a NiMH

5 Nickel-Metal-Hydride, Lead and Lithium

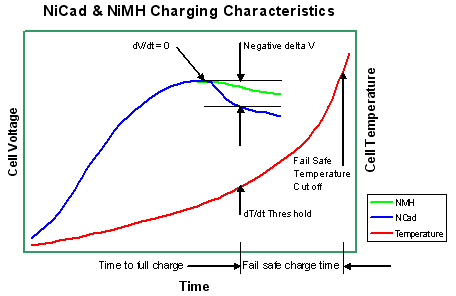
[picture p41: figure]

7-48

between 1.2V and 1.4V, and a Pb cell is about 1.9V to 2.1V depending on its charge. It would work well, until those ranges overlap with increasing cell count, then one cannot be positively sure of the cell count. At least, if one knows what kind of battery it is, then one can easily get the cell count. Usually a battery will show its capacity on the outside; for example: 2200mAh, 6Ah, 900mAh etc. Sometimes they give the C rating⁶ as well, but for our purposes we will assume the C rating is 1. One could even discharge the battery to determine the C rating, but that risks overheating and explosions if one is not careful.

In fact, to be very safe, we will charge batteries at 0.1C. It is a generally accepted value as well. The purpose of the project is anyway to demonstrate functionality. In future, once this works, one can investigate fast charging.

Examples of battery charging profiles are:

Figure 2: NiMH

6
See Glossary

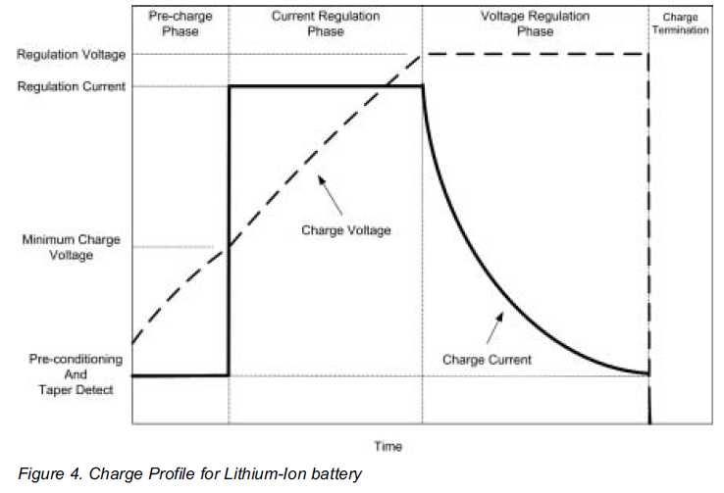
[picture p42: figure]
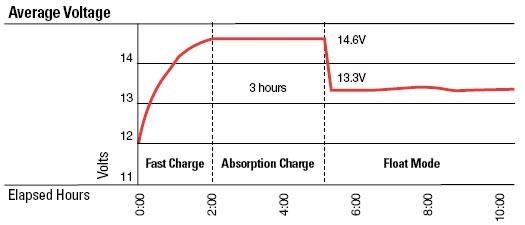
[picture p43: figure]

7-49

Figure 3: Lithium

Figure 4: Lead

Therefore, in the end, all one needs to know is the type of battery, and the power supply will do the rest.

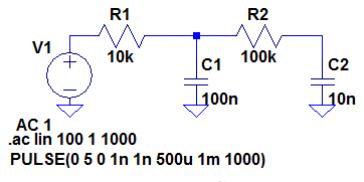
[picture p44: figure]

7-50

7.5.3 Cellular connectivity

This is an interesting one. The designer would have added this functionality had there been more time. Of course, one can get an estimate of when a battery will finish charging, but since it’s not that easy to determine the exact capacity of a battery upon charging, one might like a notification of when the battery is finished charging, so that one can put the next set on. This is especially helpful if one wants to investigate fast charging, as mentioned in 7.3.2. Sometimes one is busy with time-critical applications that require portable batteries as the sole source of power. Examples include aerial vehicles or electric cars.

7.6 Arduino Interface

The Arduino has set.voltage.value and a set.current.value functions. These functions translate a value into a duty cycle of a 980Hz PWM signal. This signal is then filtered as documented in 7.4.1.

The Arduino also has calibration procedures related to the reading of voltages and currents. This is documented in 7.4.2.

Calculations are documented in Appendix E 12.7.

7.6.1 Inputs (PWM RC filters)

This refers to the inputs on the PCB from the Arduino.

Figure 7-5: RC filter

The PWM signal from the Arduino needs to be filtered. A second order filter was chosen so that there is less ripple.

Analysis:

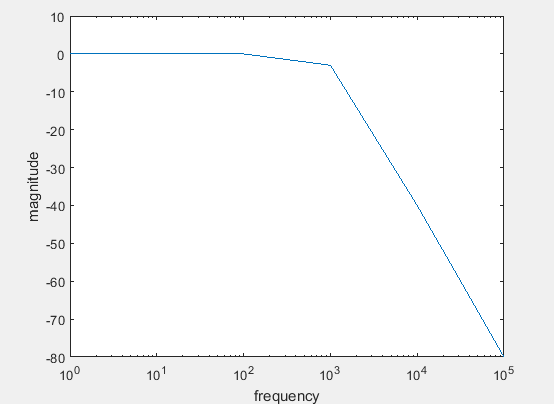
[picture p45: figure]
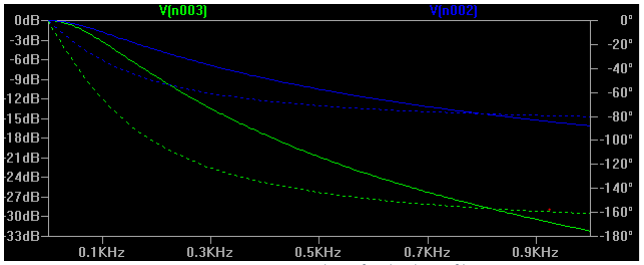
[picture p46: figure]

7-51

Figure 7-6: Theoretical 2nd order filter

Figure 7-7: Spice analysis of 2nd order RC filter

Notice how the green line decreases at double the gradient as opposed to the blue line.

Building the Circuit:
The RC filters were attached to a switch, which switched between Arduino input and potentiometer input.

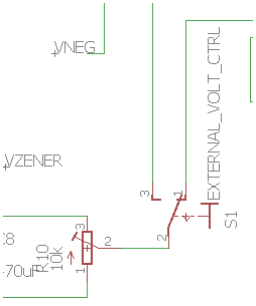
[picture p47: figure]
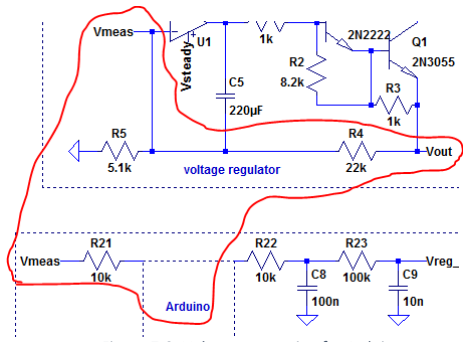
[picture p48: figure]

7-52

Figure 7-8: Switch to switch between pot and Arduino

Measurements:
Comparison of theoretical and measured:
Conclusion and recommendations:
The RC filter is quite effective, with next to nothing ripple.

7.6.2 Outputs

This refers to the outputs on the PCB to the Arduino. Design:

Figure 7-9: Voltage measuring for Arduino

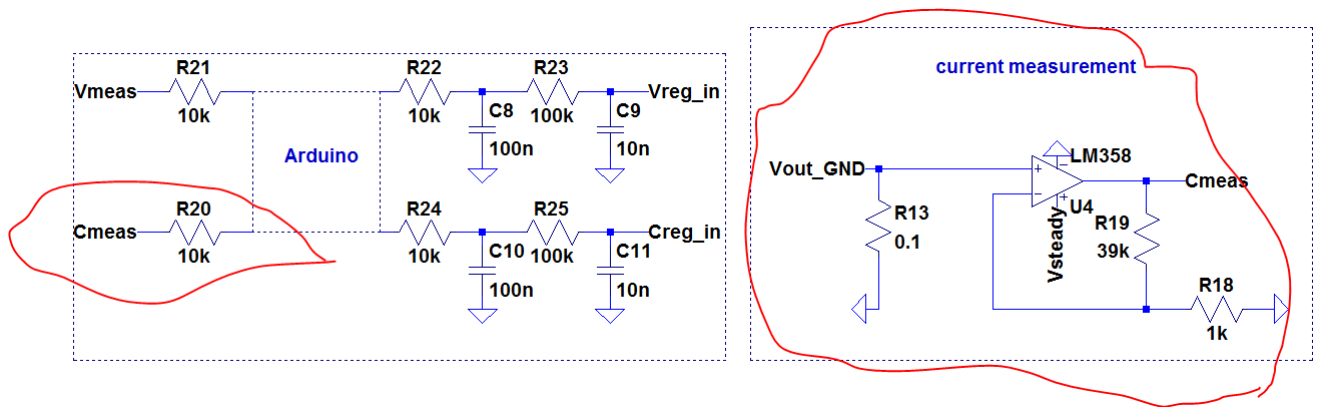
[picture p49: figure]
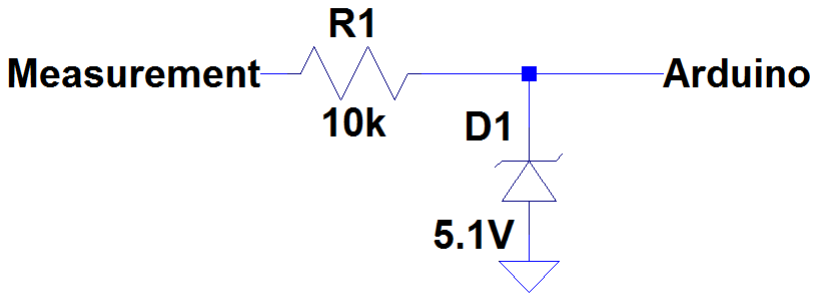
[picture p50: figure]

7-53

Figure 7-10: Current measurement

Analysis:
The voltage divider ensures that that maximum voltage that the Arduino will take is 5.1k/(5.1k+22k) * 26V is 4.89V, which is under 5V.
The current gain ensured that the max measurement to the Arduino is 0.1*(1+39k/1k) = 0.1*40 = 4V.
Building the circuit:
As mentioned in the conclusion, protection diodes are thoughtful.
Measurements:
The measurements never exceeded 5V.
Comparison of theoretical and measured values
Conclusion and recommendations:
Adding a 5.1V clamping diode to both the voltage and current measurements would be a good idea. An example follows:

Figure 7-11: Arduino protection

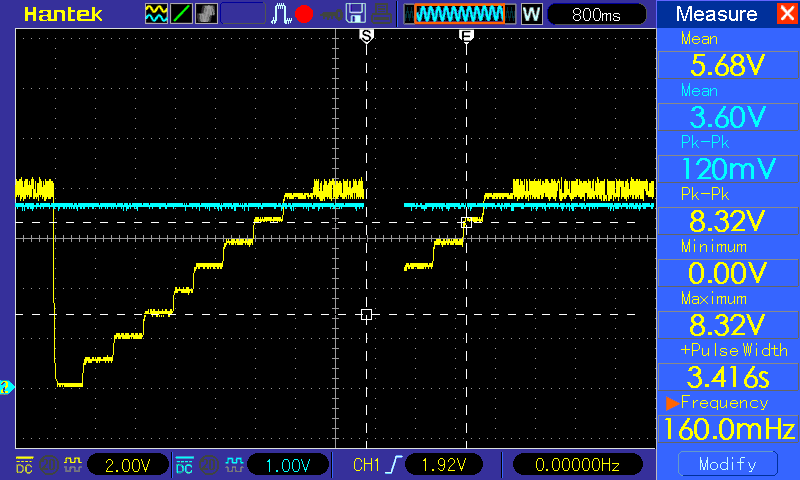
[picture p51: figure]
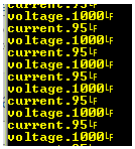
[picture p52: figure]

7-54

7.7 Complete System Integration (+digital)

Figure 7-12: Creating staircases

Figure 7-13: reading voltages and currents over 10 ohm load.

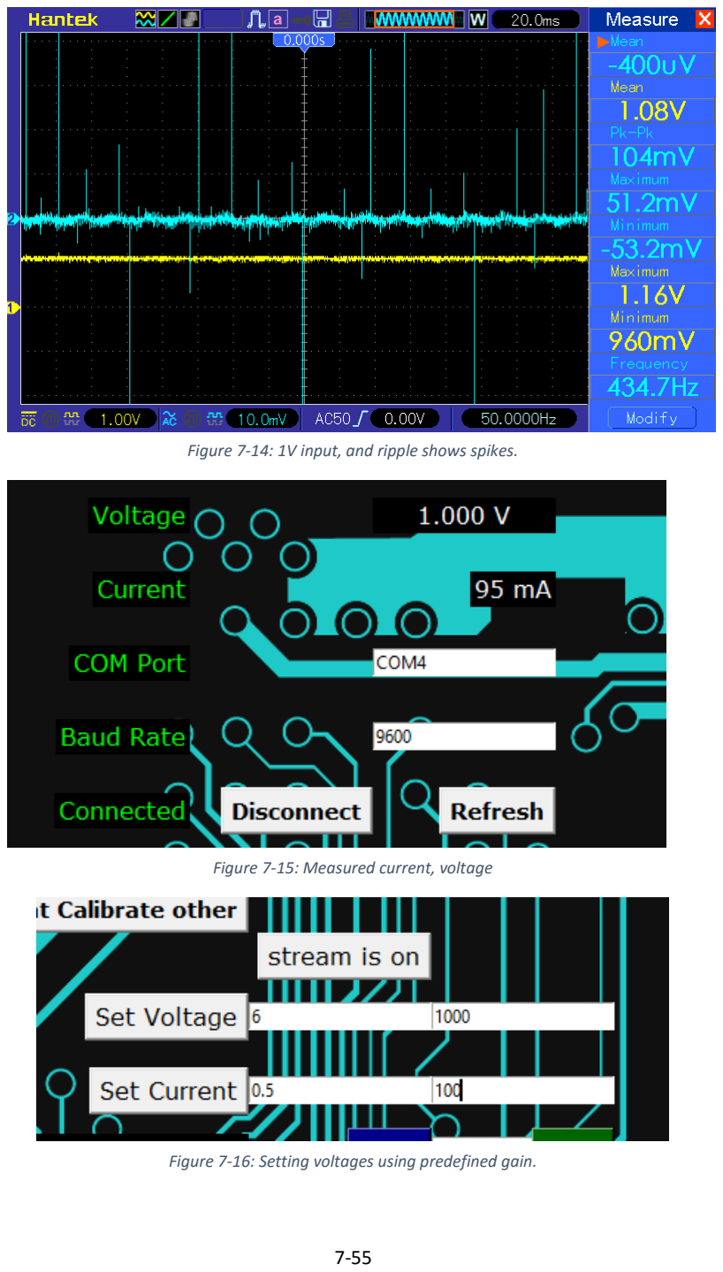
[picture p53: page 55]

7-55

Figure 7-14: 1V input, and ripple shows spikes.

Figure 7-15: Measured current, voltage

Figure 7-16: Setting voltages using predefined gain.

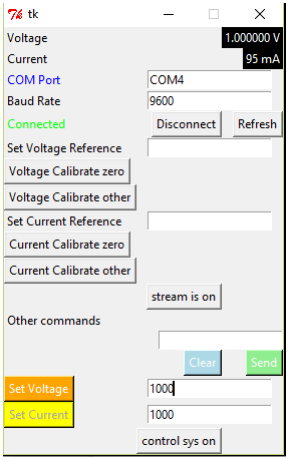
[picture p54: figure]

8-56

Figure 7-17: Earlier version

This has the control system built in. Both versions have an automatic COM port identification system.

7.7.1 Interpretation of results in Appendix A

Current did not work. It just causes oscillation. Should be an easy fix, however, it will be left as it is. Voltage work perfectly. The scale of the current was not correct due to the Arduino not working properly on the lab PC. Could not calibrate at the lab, but could calibrate at home.

## 8 Appendix A: Measured Demonstration Results

See 6.2 for interpretation.

8-57

Voltage Regulation
Set Voltage | Set Current | Before Vout DC | Before Vout AC p-p | Load (ohms) | After Vout DC | After Vout AC p-p | Comments
0V | > 1A | 0V | N/A | N/A | N/A | N/A
>16V | >1A | 16V | N/A | N/A | N/A | N/A
1.1V | >1A | 1.2V | <20m | 1.1 | 0.84V | <15m
10V | >1A | 9.9V | <20m | 10 | 9.35V | <15m
14V | >1A | 14V | <20m | 35 | 13.6V | 110m

Current Regulation
14V | 100mA | 14V | <20m | 10 | 1V | 220m
10V | 1A | 10V | 20m | 1.1 | 3.6V | 120m

Extra Hardware functions:
PCB layout + engraving.
Designed for single rail transformer.

PC controlled
Set Voltage | Set Current | Load (ohms) | Arduino Voltage | Arduino Current | After Vout DC | After Vout AC | Comments
10V | 1000mA | 35 | 10.05V | 225mA | 10 | <20m | Current Scale wrong
10V | 100mA | 35 | 10.05V | 225mA | 10 | <20m | Not working

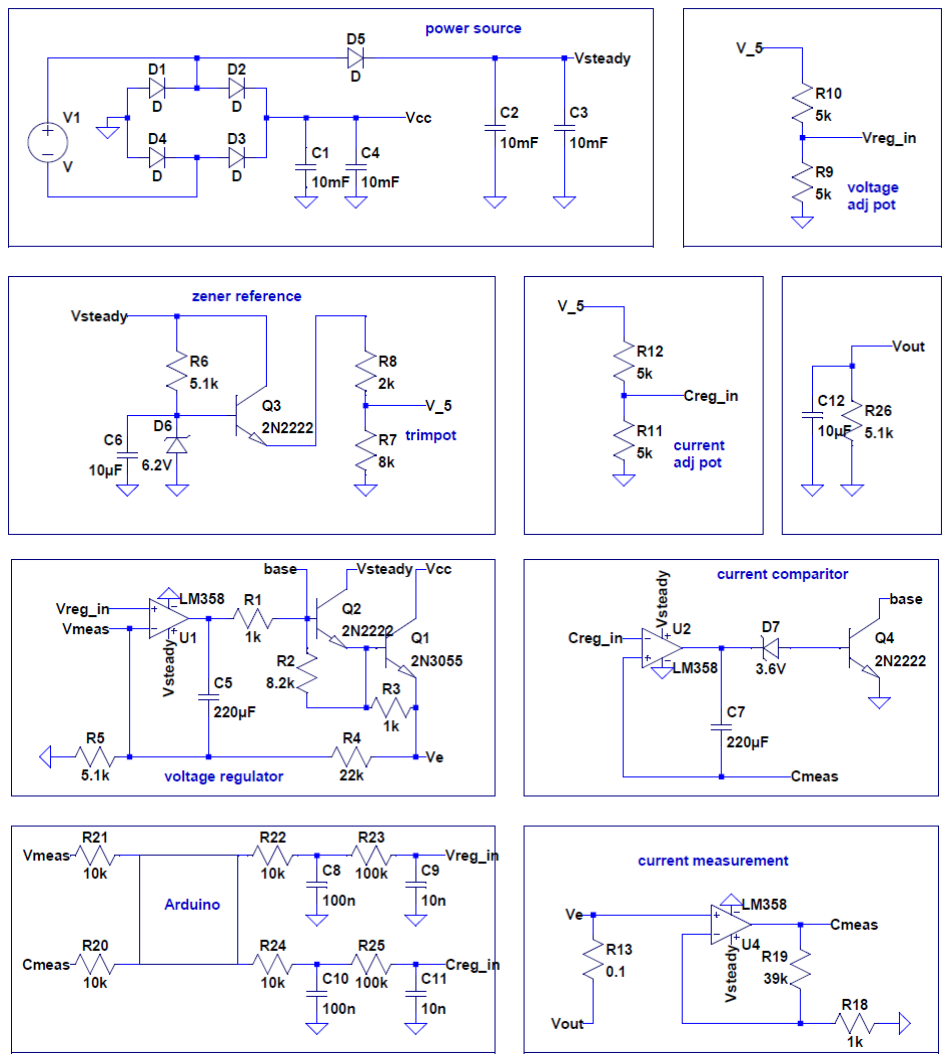
[picture p55: figure]

9-58

## 9 Appendix B: Circuit Diagram

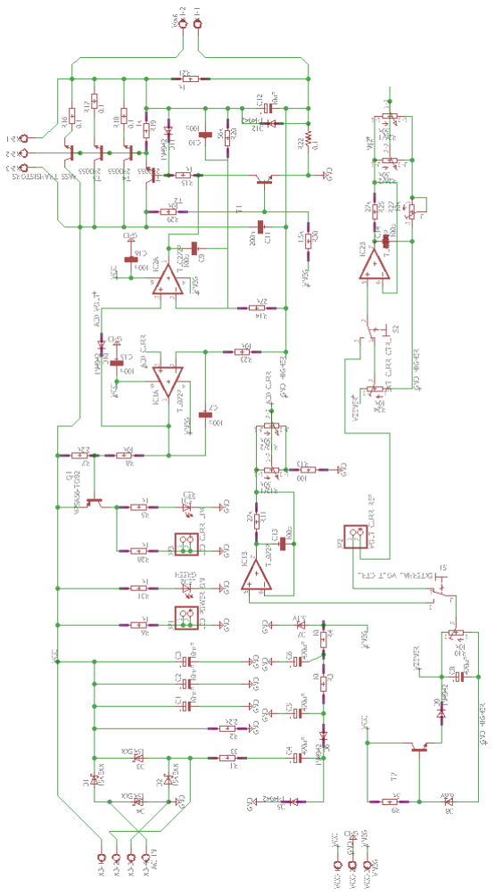
[picture p56: figure]

9-59

Figure 9-1: PCB schematic before printing

## 10 Appendix C: PCB Layout

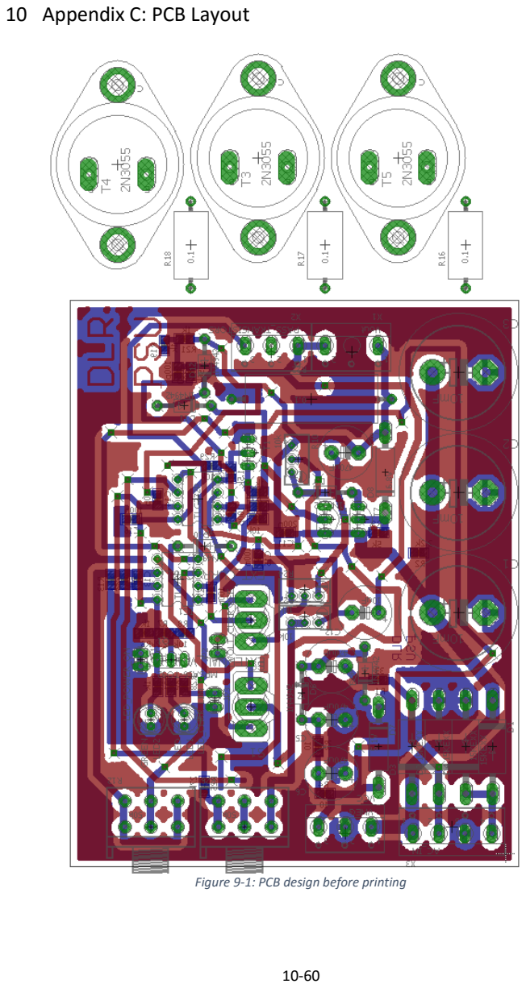
[picture p57: page 60]

10-60

Figure 9-1: PCB design before printing

## 11 Appendix D: Photo of Circuit

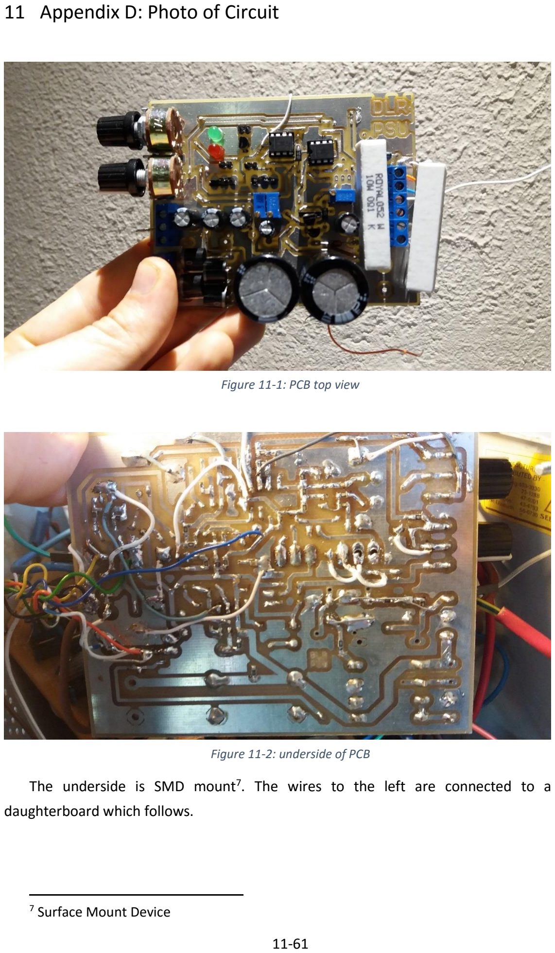
[picture p58: page 61]

11-61

Figure 11-1: PCB top view

Figure 11-2: underside of PCB

The underside is SMD mount⁷ . The wires to the left are connected to a daughterboard which follows.

7
Surface Mount Device

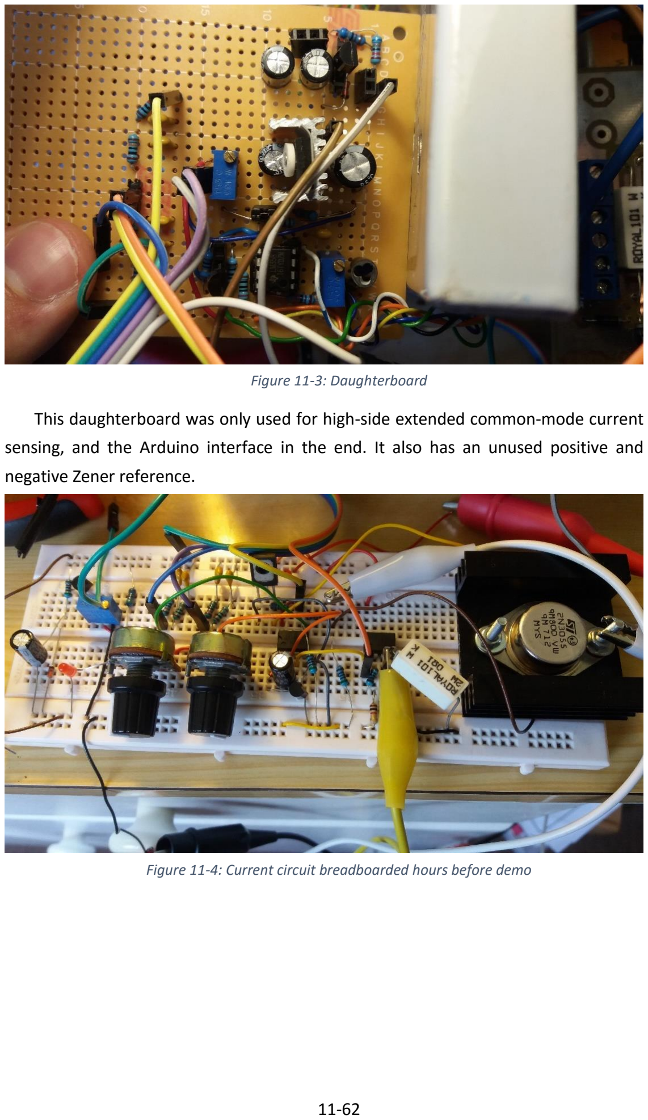
[picture p59: page 62]

11-62

Figure 11-3: Daughterboard

This daughterboard was only used for high-side extended common-mode current sensing, and the Arduino interface in the end. It also has an unused positive and negative Zener reference.

Figure 11-4: Current circuit breadboarded hours before demo

12-63

## 12 Appendix E: Calculations

12.1 Appendix E.1: Transformers

Rseries = (Voc – VL)*RL/VL
Iload = 22.4/20 = 1.12A
Rseries = (25.6 – 22.4)/1.12 = 2.86 ohms

12.2 Appendix E.2: Rectifiers & Capacitor Banks

Vripple = 500mV

12.3 Appendix E.3: Zener Constant Voltage Reference

Zener reference is 5V exactly. Zener needs 1 to 4mA at least to be biased in linear region. 10/5k = 2mA, therefore it is biased in linear region.

12.4 Appendix E.4: Pass Output Stage

Tj = Ta + Pd(θjunctioncase + θmica + θcaseℎeatsink) 150 = 25 + Pd(0.657 + 0.9 + 1.1) Pd = 47.01W

12.5 Appendix E.5: Voltage Regulator

N/A see 5.5

12.6 Appendix E.6: Current Limiter

N/A see 5.6

12.7 Appendix E.7: Arduino Interface

12.7.1 PWM filter

Figure 12-1: 2nd order PWM filter

12-64

Both RC LPFs⁸ were chosen to have the same -3dB cut-off frequency. R22 was chosen to be 10k so that the max current through it would be 5
10k

= 500μA

Because the -3dB was chosen to be 1ms which is analogous to 1kHz (close to PWM frequency of 980Hz), the capacitor C8 value is:
1m = RC = 10k ∙ C
∴ C = 100n
R23 is chosen to be larger so that the extra current draw through R22 is minimal. Had that not been the case, the max voltage out of the PWM filter would never reach 5V.
Choose R23 = 100k
∴ C9 = 10n
Since it is now a 2nd order filter, the base 10 logarithmic magnitude decreases at a rate of -40dB/div.

8
Low Pass Filters

13-65

## 13 Appendix F: Source code

"""
@authors:
Jean de Smidt 18393799
Karlien Heyns 18552463
Tristan Nel 18179460
Daniel Leonard Robinson 18361137

This is a program designed to interface between a 15W power supply
and a PC via an Ardiuno.
It uses the serial standard at 9600 baud.
It is for Design E344 at Stellenbosch University

It includes calibration procedures, as well as viewing measurements,
and setting voltages or currents.

It is not yet production level, and is merely a proof of concept
prototype for the purposes of demonstrating the functionality
of a power supply via a PC.

Lastly, this can be used as a platform to add features, such as battery charging using profiles for lead, NiH, lithium etc.
"""

import sys, string, re
from util import *
import PIL.Image
from PIL import *
import PIL.ImageTk

import serial.tools.list_ports

if sys.version_info<(3,3,0): from Tkinter import *
else:
from tkinter import *
import tkFont

# If you see an error like this:

# File "C:\GIT\software-interface\SerialComms.py", line 12, in <module>

13-66

# | import serial

# ImportError: No module named serial

# Then run this command in your terminal (CMD) # python -m pip install pyserial

# If you see an error like this:

# Traceback (most recent call last):

# File "C:\Git repos\software-interface\power-supply-gui.py", line 3, in <module>

# | import PIL.Image

# ImportError: No module named PIL.Image

# Then run this command in your terminal (CMD) # python -m pip install image

import SerialComms
#s = SerialComms.SerialComms('COM1',9600) #s.receive()

root = Tk()

root.title("Bruhhhhh. pls.") root.geometry("580x720")
root.resizable(width=False,height=False)

frame = Frame(root, width=580,height=720) #frame.configure(width=800,height=800) frame.grid_propagate(0)
frame.grid(row = 0, column = 0)
labelfont = tkFont.Font(family = "Verdana", size = 12) buttonfont = tkFont.Font(family = "Verdana", size = 11, weight = tkFont.BOLD)
image = PIL.Image.open("a.png")
photo = PIL.ImageTk.PhotoImage(image)

# variables

stream_enabled = False
stream_checked = False
connected = False
SerialComm = None

#calibration variables

#outvalue = vratio*(vmeasured-voffset) vratio = 1.0

voffset = 0.0
iratio = 1.0
ioffset = 0.0
print("First instance of ratio") # text fields
stream_text = StringVar()
volt_meas_val_text = StringVar()

13-67

curr_meas_val_text = StringVar()

#functions

def on_off(enabled):
if enabled:
return "on"
else:
return "off"

#All the labels

background = Label(frame, image = photo).place(x=0,y=0,relwidth=1, relheight=1)

voltagelabel = Label(frame, text="Voltage", bg="black", fg = "green", font = labelfont)
currentlabel = Label(frame, text="Current", bg="black", fg = "green", font = labelfont)
comportlabel = Label(frame, text="COM Port", bg="black", fg = "green", font = labelfont)
baudratelabel = Label(frame, text= "Baud Rate", bg="black", fg = "green", font = labelfont)
setvreflabel = Label(frame, text= "Set Voltage Reference", bg = "black", fg = "green", font = labelfont)
setcreflabel = Label(frame, text= "Set Current Reference", bg = "black", fg = "green", font = labelfont)
errorlabel = Label(frame, text="Disconnected", bg = "black", fg="red", font = labelfont)
otherlabel = Label(frame, text = "Other commands", bg = "black", fg = "green", font = labelfont)

voltagevaluelabel = Label(frame, textvariable=volt_meas_val_text, bg = "black", fg="white", font = labelfont)
currentvaluelabel = Label(frame, textvariable=curr_meas_val_text, bg = "black", fg="white", font = labelfont)

setvoltagelabel = Label(frame, text="Set Voltage", bg="black", fg="white", font=labelfont) setcurrentlabel = Label(frame, text="Set Current", bg="black", fg="white", font=labelfont)

#All the textentries

v=StringVar()
baudentry = Entry(frame)
comportentry = Entry(frame) vrefentry = Entry(frame)
crefentry = Entry(frame)
sendentry = Entry(frame)
setvoltageentry = Entry(frame) setcurrententry = Entry(frame) setvoltagegainentry = Entry(frame)

13-68

setcurrentgainentry = Entry(frame)

#All the buttons

connect = Button(frame, text="Connect", font = buttonfont) vcalz = Button(frame, text="Voltage Calibrate zero", font = buttonfont)
vcalo = Button(frame,text = "Voltage Calibrate other", font = buttonfont)
ccalz = Button(frame,text = "Current Calibrate zero", font = buttonfont)
ccalo = Button(frame,text = "Current Calibrate other", font = buttonfont)
refresh = Button(frame, text = "Refresh", font = buttonfont) send = Button(frame, text = "Send", bg="dark green", fg="white", font = buttonfont)
clear = Button(frame, text = "Clear", bg="dark blue", fg="white", font = buttonfont)

streambutton = Button(frame, textvariable=stream_text, font = labelfont)
setvoltagebutton = Button(frame, text="Set Voltage", font=labelfont)
setcurrentbutton = Button(frame, text="Set Current", font=labelfont)

#All the label layout

frame.grid_columnconfigure(0, minsize = 150) frame.grid_columnconfigure(1, minsize = 100) frame.grid_rowconfigure(0, minsize = 50) frame.grid_rowconfigure(1, minsize = 50) frame.grid_rowconfigure(2, minsize = 50) frame.grid_rowconfigure(3, minsize = 50) frame.grid_rowconfigure(4, minsize = 50) frame.grid_rowconfigure(6, minsize = 50) frame.grid_rowconfigure(9, minsize = 50) frame.grid_rowconfigure(13, minsize = 50) frame.grid_rowconfigure(14, minsize = 50) voltagelabel.grid(row =0, column=0, sticky=E) voltagevaluelabel.grid(row=0, column=2, sticky=W+E) currentlabel.grid(row=1,column=0,sticky=E) currentvaluelabel.grid(row=1, column=2, sticky=E) comportlabel.grid(row=2,column=0,sticky=E) baudratelabel.grid(row=3,column=0,sticky=E) errorlabel.grid(row=4, column=0, sticky=E) setvreflabel.grid(row=6,column=0,sticky=E) setcreflabel.grid(row=9,column=0,sticky=E) otherlabel.grid(row=15,column=0,sticky=E)

#All the textentry layout

baudentry.grid(row=3,column=1,columnspan=2, sticky=E) comportentry.grid(row=2,column=1,columnspan=2, sticky=E) vrefentry.grid(row=6,column=1,columnspan=2, sticky=E) crefentry.grid(row=9,column=1,columnspan=2, sticky=E) sendentry.grid(row=15,column=1, columnspan=2, sticky=E)

13-69

setvoltagegainentry.grid(row=13, column=1, columnspan=1, sticky=E)
setvoltageentry.grid(row=13, column=2, columnspan=1, sticky=E)
setcurrentgainentry.grid(row=14, column=1, columnspan=1, sticky=E)
setcurrententry.grid(row=14, column=2, columnspan=1, sticky=E)
# maybe we don't need these two lines? #frame.columnconfigure(2, weight=3) #frame.columnconfigure(3, weight=3)

#All the buttons layout

connect.grid(row=4,column=1,sticky = E) refresh.grid(row=4,column=2,sticky=E) setvreflabel.grid(row=6,column=0) vcalz.grid(row=7,column=0,sticky=E) vcalo.grid(row=8,column=0,stick=E) ccalz.grid(row=10,column=0,sticky=E) ccalo.grid(row=11,column=0,sticky=E) streambutton.grid(row=12,column=1,sticky=E) clear.grid(row=15,column=1,sticky=E) send.grid(row=15,column=2,sticky=E) setvoltagebutton.grid(row=13, column=0, sticky=E) setcurrentbutton.grid(row=14, column=0, sticky=E)

# setup

stream_text.set("stream is %s" % on_off(False)) | #maybe
change text to a command ("Turn stream on") to show it is a button that can be pressed
volt_meas_val_text.set("0.000 V") | #should always
display the same nr of digits curr_meas_val_text.set("0.000 A")

def find_arduino():
serPort = ""

# Find Live Ports

ports = list(serial.tools.list_ports.comports())
for p in ports:
# debug automatically finding Arduino by uncommenting next line

# print p

for obj in p:
if "Arduino" in obj:
serPort = p[0]
print "Found Arduino at %s\n" % serPort return serPort

#All the events

13-70

def connectf(event):
global SerialComm
global connected
#Check if existing connection is open

if SerialComm is None: #Open new connection print 'Connecting'
try:
#Get values

baud = baudentry.get()
comport = comportentry.get()

#Input error checking

check = False
r = re.compile('^COM\d+$') # print r.match(comport)
if not baud.isdigit():
check = True
baudentry.delete(0,END)
baudentry.insert(0,'Enter a number as the baud rate!')
if not r.match(comport) is not None:
check = True
comportentry.delete(0,END) comportentry.insert(0,'Must be format: COM%number%')
if check:
errorlabel.config(text='Invalid input!', fg='Red')
return
errorlabel.config(text='')

#Establish connection

SerialComm = SerialComms.SerialComms(comport, baud)
SerialComm.open()

#Change UI

connect.config(text='Disconnect') errorlabel.config(text='Connected', fg='Green', font = labelfont)

connected = True
print "Connected!"
except:
SerialComm = None
errorlabel.config(text='Unable to connect! Try again', fg='Red')
return

else: #Disconnect
connected = False
try:
print 'Disconnecting...'
#Close connection

13-71

SerialComm.close()
SerialComm = None

#Change GUI

connect.config(text='Connect') errorlabel.config(text='Disconnected', fg='Red', font = labelfont) except:
errorlabel.config(text='Unable to disconnect! Try again')
return
def vcalzerof(event):
setVOffset()
def vcalotherf(event):
try:
x=float(vrefentry.get())
setVRatio()
except ValueError:
print("You must enter a number ")

def ccalzerof(event):
setIOffset()
def ccalotherf(event):
try:
x=float(crefentry.get())
setIRatio()
except ValueError:
print("You must enter a number ") def sendf(event=0):
command = sendentry.get()
SerialComm.send(command)
print command

def clearf(event=0):
sendentry.delete(0,END)
print "cleared"

def streamf(event=0):
global stream_enabled
stream_enabled ^= True
#should change to false with new button text? print("streaming measurements: " + str(stream_enabled))

stream_text.set("stream is %s" % on_off(stream_enabled)) #("Turn stream on/off") SerialComm.send("stream.%s" % on_off(stream_enabled))

def refresh_comport(event=0): comportentry.delete(0,END) comportentry.insert(0,find_arduino())

def setvoltagef(event=0):
global SerialComm
global connected

13-72

if connected:
try:
# Get input data

gainText = setvoltagegainentry.get() voltageText = setvoltageentry.get()

## CHECK THE INPUT

gain = float(gainText)
voltage = float(voltageText)
# Calculate command value

value = int(voltage/gain/5*25600)

# Send command

cmd = "set.voltage." + str(value) print cmd
SerialComm.send(cmd)

except IndexError:
pass

def setcurrentf(event=0):
global SerialComm
global connected
if connected:
try:
# Get input data

gainText = setcurrentgainentry.get() currentText = setcurrententry.get()

## CHECK THE INPUT

gain = float(gainText)
current = float(currentText)
# Calculate command value

value = int(current/gain/5*1280)

# Send command

cmd = "set.current." + str(value) print cmd
SerialComm.send(cmd)

except IndexError:
pass

#Button bindings to the events connect.bind("<Button-1>",connectf) refresh.bind("<Button-1>",refresh_comport) vcalz.bind("<Button-1>",vcalzerof) vcalo.bind("<Button-1>",vcalotherf) ccalz.bind("<Button-1>",ccalzerof) ccalo.bind("<Button-1>",ccalotherf) send.bind("<Button-1>",sendf) clear.bind("<Button-1>",clearf) streambutton.bind("<Button-1>",streamf)

13-73

setvoltagebutton.bind("<Button-1>",setvoltagef) setcurrentbutton.bind("<Button-1>",setcurrentf)

update_ms = 99

def updateMeasurements():
global connected
global stream_checked
global vratio
global voffset
global iratio
global ioffset
if connected:
stream = SerialComm.receive() if (len(stream) > 0):
if not stream_checked:
# Check if there is a stream of measurements and

# update stream button

stream_checked=True
stream_enabled=False
streamf()

try:
# Process stream of voltages and currents from Arduino

current_string = stream[-1] voltage_string = stream[-2]
if isValidCurrent(current_string): current_raw =
extractCurrent(current_string) curr_meas=current_raw;
curr_meas_val_text.set("%d mA" % (iratio*(curr_meas-ioffset)))

if isValidVoltage(voltage_string): voltage_raw =
extractVoltage(voltage_string) volt_meas=float(voltage_raw)/1000; #print("What is the ratio %f", vratio) #print("What is the offset %f", voffset) #print("What is the Meas %f", volt_meas) volt_meas_val_text.set("%.3f V" % (vratio*(volt_meas-voffset)))
except IndexError:
pass
root.after(update_ms,updateMeasurements) def setVRatio():
global connected
global stream_checked
global vratio
global voffset
if connected:
stream = SerialComm.receive()

13-74

if (len(stream) > 0):
if not stream_checked:
# Check if there is a stream of measurements and

# update stream button

stream_checked=True
stream_enabled=False
streamf()

try:
# Process stream of voltages and currents from Arduino

voltage_string = stream[-2]
if isValidVoltage(voltage_string): voltage_raw =
extractVoltage(voltage_string) volt_meas=float(voltage_raw)/1000; vratio =
float(vrefentry.get())/volt_meas; print("Actual: %s",vrefentry.get()) print("Measured: %s",volt_meas) print("Changed Ratio %f", vratio) volt_meas_val_text.set("%.3f V"% (vratio*(volt_meas-voffset))) except IndexError:
pass

def setVOffset():
global connected
global stream_checked
global voffset
global vratio
if connected:
stream = SerialComm.receive() if (len(stream) > 0):
if not stream_checked:
# Check if there is a stream of measurements and

# update stream button

stream_checked=True
stream_enabled=False
streamf()

try:
# Process stream of voltages and currents from Arduino

voltage_string = stream[-2]
if isValidVoltage(voltage_string): voltage_raw =
extractVoltage(voltage_string) volt_meas=float(voltage_raw)/1000; voffset = volt_meas;
print("Voffset is %f",voffset)

13-75

volt_meas_val_text.set("%.3f V" % (vratio*(volt_meas-voffset))) except IndexError:
pass
def setIRatio():
global connected
global stream_checked
global iratio
global ioffset
if connected:
stream = SerialComm.receive() if (len(stream) > 0):
if not stream_checked:
# Check if there is a stream of measurements and

# update stream button

stream_checked=True
stream_enabled=False
streamf()

try:
# Process stream of voltages and currents from Arduino

current_string = stream[-1]
if isValidCurrent(current_string): current_raw =
extractCurrent(current_string) curr_meas=current_raw;
ioffset = curr_meas
print("I offset %f",ioffset) curr_meas_val_text.set("%d mA" % (iratio*(curr_meas-ioffset)))

except IndexError:
pass

def setIOffset():
global connected
global stream_checked
global iratio
global ioffset
if connected:
stream = SerialComm.receive() if (len(stream) > 0):
if not stream_checked:
# Check if there is a stream of measurements and

# update stream button

stream_checked=True
stream_enabled=False
streamf()

try:

13-76

# Process stream of voltages and currents from Arduino

current_string = stream[-1]
if isValidCurrent(current_string): current_raw =
extractCurrent(current_string) curr_meas=current_raw;
ioffset = curr_meas
curr_meas_val_text.set("%d mA" % (iratio*(curr_meas-ioffset)))

except IndexError:
pass

def setup():
# runs once on startup

refresh_comport()
baudentry.delete(0,END)
baudentry.insert(0,9600)

try:
setup()
root.after(update_ms,updateMeasurements) root.mainloop()
except KeyboardInterrupt:
print 'Goodbye'
finally:
if SerialComm is not None: print 'Disconnecting...'
try:
SerialComm.close()
except:
errorlabel.config(text="Failed to disconnect") exit

16-77

## 14 Appendix G: Extra information

14.1 Extra Hardware Features

14.1.1 Battery charging profiles

See 7.3.2 for more information.
Switches can be added to identify between NiMH, Pb and Li cells.

## 15 Final Conclusion

It was a good project. It took much longer than expected. The extra mile was indeed taken, but ultimately it makes one a good engineer to struggle. The project will form a good basis for electronic circuits in future, and the valuable experience garnered from it is not to be taken lightly.

I would like to acknowledge Prof JB De Swardt and Dr RD Beyers for making this project possible.

## 16 Figures

[7]
Figure 5-1: 15V transformer secured | 5-13
Figure 5-2: 9V dual transformer and two diode bridges (right) | 5-13
Figure 5-3: The dual 16V transformer | 5-14
Figure 5-4: 160W transformer | 5-14
Figure 5-5: Couple of dual LM358s | 5-15
Figure 5-6: simple thevinin equivalent 15V transformer model | 5-15
Figure 5-7: voltage drop after series resistance (blue), current (red) | 5-16
Figure 8: Crimp connectors | 5-16
Figure 5-9: 15V transformer open circuited | 5-17
Figure 5-10: 15V transformer loaded with 20 ohms | 5-17
Figure 5-11: Bridge and capacitors | 5-19
Figure 5-12: 15 ohm load, and 1k represents the load of the rest of circuit.......5-20
Figure 5-13: Diode + capacitor bank under load | 5-20
Figure 5-14: Old diode bridge | 5-21

16-78

Figure 5-15: New diode bridge with crimp connectors secured | 5-21
Figure 5-16: 10 mF capacitor bank | 5-22
Figure 5-17: steady voltage over time | 5-23
Figure 5-18: Zener reference circuit | 5-24
Figure 5-19: Zener circuit tuned output | 5-24
Figure 5-20: Sziklai pair | 5-26
Figure 5-21: Darlington pair | 5-26
Figure 5-22: 2N3055 transistor | 5-27
Figure 5-23: Final pass transistor output stage design | 5-27
Figure 5-24: Three outboard pass transistor output stage | 5-28
Figure 5-25: Outboard pass transistors to be used in design | 5-28
Figure 5-26: 2N3055 Heatsink | 5-29
Figure 5-27: Voltage regulator | 5-31
Figure 5-28: Output voltage at 12V (blue), op amp steadies at 16V | 5-32
Figure 5-29: 10 ohm load, constant voltage, ripple negligible | 5-33
Figure 5-30: current comparitor and measurement | 5-34
Figure 5-31: Output characteristics of LM358 | 5-35
Figure 5-32: Current limiter set up to limit 100mA | 5-36
Figure 5-33: Current limiter in action limiting 100mA (red) | 5-36
Figure 5-34: Current limiting at 100mA, 30mVp-p | 5-37
Figure 6-1: One favourite picture, 2mV ripple under 1A load | 6-40
Figure 7-1: Software interface | 7-46
Figure 2: NiMH | 7-48
Figure 3: Lithium | 7-49
Figure 4: Lead | 7-49
Figure 7-5: RC filter | 7-50
Figure 7-6: Theoretical 2nd order filter | 7-51
Figure 7-7: Spice analysis of 2nd order RC filter | 7-51
Figure 7-8: Switch to switch between pot and Arduino | 7-52
Figure 7-9: Voltage measuring for Arduino | 7-52
Figure 7-10: Current measurement | 7-53
Figure 7-11: Arduino protection | 7-53
Figure 7-12: Creating staircases | 7-54
Figure 7-13: reading voltages and currents over 10 ohm load | 7-54
Figure 7-14: 1V input, and ripple shows spikes | 7-55
Figure 7-15: Measured current, voltage | 7-55
Figure 7-16: Setting voltages using predefined gain | 7-55

16-79

Figure 7-17: Earlier version | 7-56
Figure 9-1: PCB schematic before printing | 9-59
Figure 9-1: PCB design before printing | 10-60
Figure 11-1: PCB top view | 11-61
Figure 11-2: underside of PCB | 11-61
Figure 11-3: Daughterboard | 11-62
Figure 11-4: Current circuit breadboarded hours before demo | 11-62
Figure 12-1: 2nd order PWM filter | 12-63

18-80

## 17 Glossary

Transconductance – Current gain resulting from voltage input.

C rating – It is a multiple of the capacity, and thus reflective of the rate at which one can charge/discharge the battery.

## 18 Index

SMD mount, 11-61 | transconductance, 7-47

19-81

## 19 Bibliography

[1] “TL081,” [Online]. Available: www.ti.com/product/TL081.
[2] “LM358,” [Online]. Available: www.ti.com/lit/ds/symlink/lm158-n.pdf.
[3] “https://en.wikipedia.org/wiki/Sziklai_pair,” [Online].
[4] “https://en.wikipedia.org/wiki/2N3055,” [Online].
[5] “https://en.wikipedia.org/wiki/Thermal_runaway,” [Online].
[6] “2N2222,” [Online]. Available: https://en.wikipedia.org/wiki/2N2222.
[7] | “TIP41C,” | [Online]. | Available:
www.st.com/resource/en/datasheet/CD00142950.pdf.
[8] D. Jones. [Online]. Available: https://youtu.be/tF2krfxYc68.

http://www.electronics-lab.com/project/0-30-vdc-stabilized-power-supply-with-current-control-0-002-3-a/http://diyfan.blogspot.co.za/2013/03/adjustable-lab-power-supp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
http://www.sentex.ca/~mec1995/circ/ps3010/ps3010a.htmlhttp://www.northcountryradio.com/PDFs/030702002.pdfhttp://www.tuxgraphics.org/electronics/201005/bench-power-su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
http://www.linear.com/solutions/5788

19-82

http://www.ti.com/lit/an/slyt183/slyt183.pdfhttp://www.simonbramble.co.uk/lt_spice/ltspice_lt_spice_tutorial_3.htmhttp://www.eetimes.com/document.asp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
