dan-leo/digital-power-supply/schematic/cccv_psu_4.asc

C1: cap; 10mF; Rser=0.1
C2: cap; 10mF; Rser=0.1
C3: cap; 10mF; Rser=0.1
C4: cap; 10mF; Rser=0.1
C5: cap; 220µF
C6: cap; 10µF
C7: cap; 220µF; Rser=0.1
C8: cap; 100n
C9: cap; 10n
C10: cap; 100n
C11: cap; 10n
C12: cap; 10µF
C13: cap; 220µF; Rser=0.1
C14: cap; 10µF
C15: cap; 220µF
D1: diode
D2: diode
D3: diode
D4: diode
D5: diode
D6: zener; BZX84C6V2L
D7: zener; 1N747
Q1: npn; 2N3055
Q2: npn; 2N2222
Q3: npn; 2N2222
Q4: npn; 2N2222
R1: res; 1k
R2: res; 8.2k
R3: res; 1k
R4: res; 10k
R5: res; 5.1k
R6: res; 5.1k
R7: res; 9.6k
R8: res; 400
R9: res; 8k
R10: res; 2k
R11: res; 1k
R12: res; 9k
R13: res; 0.1
R18: res; 1k
R19: res; 39k
R20: res; 10k
R21: res; 10k
R22: res; 10k
R23: res; 100k
R24: res; 10k
R25: res; 100k
R26: res; 5.1k
R_load: res; 12
U1: opamp2; LM358
U2: opamp2; LM358
U4: opamp2; LM358
V1: voltage; SINE(0 25.6 50); Rser=2.86
Named nets: 0, Vcc, Vsteady, base, Vreg_in, V_5, Creg_in, Cmeas, Vmeas, Vout, Vout_GND
.inc C:\\GIT\\digital-power-supply\\schematic\\LM358.101
trimpot
current
adj pot
voltage
adj pot
current comparitor
current measurement
voltage regulator
power source
Digital power supply
18361137
Daniel Robinson
19-Oct-2016
Arduino
zener reference
.tran 10
3.6V
6.2V
.ic V(N001)=24.5
