dan-leo/digital-power-supply/schematic/cccv_psu_3.asc

C1: cap; 10mF; Rser=0.1
C2: cap; 10mF; Rser=0.1
C3: cap; 10mF; Rser=0.1
C4: cap; 10mF; Rser=0.1
C5: cap; 220µF
C6: cap; 10µF
C7: cap; 220µF
C8: cap; 100n
C9: cap; 10n
C10: cap; 100n
C11: cap; 10n
D1: diode
D2: diode
D3: diode
D4: diode
D5: diode
D6: zener; 6.2V
D7: zener; 3.6V
Q1: npn; 2N3055
Q2: npn; 2N2222
Q3: npn; 2N2222
Q4: npn; 2N2222
Q5: npn; 2N2222
Q6: npn; 2N2222
R1: res; 1k
R2: res; 8.2k
R3: res; 1k
R4: res; 22k
R5: res; 5.1k
R6: res; 5.1k
R7: res; 8k
R8: res; 2k
R9: res; 5k
R10: res; 5k
R11: res; 5k
R12: res; 5k
R13: res; 0.1
R14: res; 100
R15: res; 100
R16: res; 0.1
R17: res; 100
R18: res; 1k
R19: res; 39k
R20: res; 10k
R21: res; 10k
R22: res; 10k
R23: res; 100k
R24: res; 10k
R25: res; 100k
U1: opamp2; LM358
U2: opamp2; LM358
U3: opamp2; LM358
U4: opamp2; LM358
V1: voltage
Named nets: 0, Vcc, Vsteady, base, Vreg_in, V_5, Creg_in, Cmeas, Ve, Vout, Vmeas
.inc C:\\GIT\\digital-power-supply\\schematic\\LM358.101
trimpot
adj pot
adj pot
current comparitor
current measurement
voltage regulator
power source
Digital power supply
Arduino
