dan-leo/digital-power-supply/schematic/.spice/2nd_order_RC_filter.asc

C1: cap; 100n
C2: cap; 10n
R1: res; 10k
R2: res; 100k
V1: voltage; ""; AC 1
Named nets: 0
.ac lin 100 1 1000
