dan-leo/digital-power-supply/schematic/.spice/current_gain.asc

R1: res; 1k
R2: res; 10k
U1: UniversalOpamp2
V1: voltage; 15
V2: voltage; -15
V3: voltage; 10m
Named nets: 0
.tran 100ms
