dan-leo/digital-power-supply/schematic/.spice/protection_diodes.asc

D1: zener; 5.1V
R1: res; 10k
Named nets: 0, Arduino, Measurement
