dan-leo/digital-power-supply/schematic/.spice/thevinin.transformer.asc

R1: res; 10
R2: res; 2.86
V1: voltage; SINE(0 25.6 50)
Named nets: 0
.tran 50m
