dan-leo/digital-power-supply/schematic/.spice/inverted_saturation.asc

Q1: npn
Q2: pnp
R1: res; 1k
R2: res; 1k
V1: voltage; 3; Rser=50
V2: voltage; 15; Rser=50
Named nets: 0
.tran 20m
