dan-leo/digital-power-supply/schematic/.spice/3_transformers.asc

D1: diode
D2: diode
D3: diode
D4: diode
D5: diode
D6: diode
D7: diode
D8: diode
D9: diode
D10: diode
D11: diode
D12: diode
V1: voltage; SINE(0 13 50 0 0 180)
V2: voltage; SINE(0 22 50)
V3: voltage; SINE(0 13 50 0 0 180)
Named nets: 0, V24, V15, V-9
.tran 200m
