dan-leo/digital-power-supply/schematic/.spice/dac.asc

C1: cap; 16µF
C2: cap; 1.6p
R1: res; 1k
R2: res; 100k
V1: voltage; ""; PULSE(0 5 0 1n 1n 500u 1000u 1000)
V2: voltage; 15
Named nets: 0, Vcc
.inc LM358.101
.tran 1.5
;ac dec 10 1 1k
PULSE(0 5 0 1n 1n 500u 1000u 1000)
