dan-leo/digital-power-supply/schematic/.spice/current-sensing-common-mode.asc

Q1: npn; KT940A
R1: res; 0.1
R2: res; 10
R3: res; 200
R4: res; 200
R5: res; 200
U1: opamp2; LM358
V1: voltage; {Vs}
V2: voltage; 7
Named nets: 0
.inc LM358.101
.tran 1ms
.STEP param Vs 0 7 0.1
