dan-leo/digital-power-supply/schematic/.spice/Draft4.asc

C1: cap; 220µF
C2: cap; 220µF; Rser=0.1
C3: cap; 1470µF
D1: zener; 1N751
D2: diode
D3: diode
D4: diode
D5: diode
Q1: npn
R1: res; 400
R2: res; 5k
V1: voltage; SINE(0 16 50); Rser=4
Named nets: 0
5.1V
.tran 4000m
