dan-leo/digital-power-supply/schematic/.spice/negative_transformer.asc

C1: cap; 1000µF; Rser=0.1
C2: cap; 4700µF; Rser=0.1
D1: diode
D2: diode
D3: diode
D4: diode
D5: diode
D6: diode
D7: diode
D8: diode
R1: res; 200
R2: res; 200
V1: voltage; SINE(0 14 50); Rser=3
V2: voltage; SINE(0 14 50 0 0 180); Rser=3
Named nets: 0
.tran 400ms
