dan-leo/digital-power-supply/schematic/.spice/cccv_psu_v2.asc

C1: polcap; 20mF; V=50 Irms=1.95 Rser=0.028 Lser=0
C2: cap; 470µF
C3: cap; 470µF
C4: cap; 100n
C5: cap; 200n
C6: cap; 100p
C7: polcap; 10µ; V=50 Irms=170m Rser=1 Lser=0 mfg="Nichicon" pn="UPG1H100MPH" type="Al electrolytic"
C8: cap; 330p
C9: cap; 100p
C10: cap; 470µF
C11: cap; 470µF
C12: cap; 100n
C13: cap; 100n
D1: diode; DI_2W005G
D2: diode; DI_2W005G
D3: diode; DI_2W005G
D4: diode; DI_2W005G
D5: diode; 1N4001
D6: diode; 1N4001
D7: zener; 1N752
D8: zener; 1N752
D9: diode; 1N4148
D10: diode; 1N4148
D11: diode; 1N4001
D12: LED
D13: zener; 1N755
D14: diode
Q1: npn; BC548B
Q2: npn; 2N2219A
Q3: pnp; BC557B
Q4: npn; 2N3055
Q5: npn
Q6: npn; 2N3055
Q7: npn; 2N3055
Q8: npn; 2N2219A
R1: res; 2.2k; pwr=1
R2: res; 30; pwr=.25
R3: res; 1; pwr=.25
R4: res; 4.7k; pwr=.25
R5: res; 10k; pwr=.25
R6: res; 10k; pwr=.25
R7: res; 0.1; pwr=5
R8: res; 27k; pwr=.25
R9: res; 2.2k; pwr=.25
R10: res; 1
R11: res; 27k; pwr=.25
R12: res; 56k; pwr=.25
R13: res; 10k; pwr=.25
R14: res; 1.5k; pwr=.25
R15: res; 1k; pwr=.25
R16: res; 1k; pwr=.25
R17: res; 33; pwr=.25
R18: res; 56k; pwr=.25
R19: res; 2.2k; pwr=.25
R20: res; 10k; pwr=.25
R21: res; 10k; pwr=.25
R22: res; 3.9k; pwr=.25
R23: res; 5k
R24: res; 0.1; tol=10%
R25: res; 0.1; tol=10%
R26: res; 0.1; tol=10%
R27: res; 5k
R28: res; 5k
R29: res; 0.1
R31: res; 27k
R32: res; 5k
R33: res; 50k
R34: res; 10k
R35: res; 5k
R36: res; 27k
R37: res; 10k
R38: res; 10k
R_load: res; 1
R_pot1_1: res; 7.659k; pwr=.25
R_pot1_2: res; 2.34k; pwr=.25
R_pot2_1: res; 2k
R_pot2_2: res; 2k
S1: sw; SW1
U1: opamp2; TL081
U2: opamp2; TL081
U3: opamp2; TL081
U4: opamp2; TL081
U5: opamp2; TL081
V1: voltage; SINE(0 30 50); Rser=0.1
V2: voltage; PULSE(0 5 100m 0 0 500ms 250m 1)
V3: voltage; 5
V4: voltage; 0.6
Named nets: 0, V_pos, V_neg, base, ADJ_current, ADJ_voltage, Vzener, GND_higher, Volt_set, Curr_set, MEAS_curr
.tran 2
.inc TL081.301
.model SW1 SW(Ron=0.01 Roff=10Meg Vt=1.1)
.ic V(Vzener)=5.15
PULSE(0 2.5 0.2 0.3 0.3 0.2 1 1)
.ic V(V_neg)=-5
