dan-leo/digital-power-supply/schematic/.spice/currentnotsensing.asc

Q1: npn
Q2: npn
R1: res; 10
R2: res; 100
R3: res; 1k
U1: UniversalOpamp2
V1: voltage; 20
V2: voltage; PULSE(10 11 0 10m)
Named nets: 0
.tran 20ms
