dan-leo/digital-power-supply/schematic/.spice/Draft1.asc

M1: nmos; FDMS3622SQ2
Q1: npn; 2N2222
R1: res; 1k
R2: res; 300
V1: voltage; 10
V2: voltage; {Vadj}
Named nets: 0
.op
.STEP param Vadj 1.87 1.88
