dan-leo/digital-power-supply/schematic/.spice/Draft10.asc

M1: nmos; VN2222L
R1: res; 1k
V1: voltage; PULSE(0 10 1ms 1n 1n 100ms)
V2: voltage; 10
Named nets: 0
.tran 150ms
