dan-leo/digital-power-supply/schematic/.spice/Draft3.asc

A1: schmtinv
A3: schmtinv
A4: schmtinv
C1: cap; 10n
C2: cap; 10µF
C3: cap; 100µF
D1: diode
D2: diode
R1: res; 5.6k
V1: voltage; 5
Named nets: 0
.tran 0 100m 0 10u
