dan-leo/digital-power-supply/schematic/.spice/Draft5.asc

C1: cap; 10mF
D1: diode
D2: diode
D3: diode
D4: diode
D5: diode
R1: res; 3
R2: res; 1k
R3: res; 10k
V1: voltage; SINE(0 25.2 50)
Named nets: Vneg, 0
.tran 2s
