dan-leo/digital-power-supply/schematic/.spice/Draft7.asc

R1: res; 1
S1: sw; SW1
V1: voltage; PULSE(0 5 1m 1n 1n 2ms 4ms 1)
V2: voltage; 10
Named nets: 0
.tran 10ms
.model SW1 SW(Ron=10 Roff=10Meg Vt=1.1 Vh=0.1)
