dan-leo/digital-power-supply/schematic/.spice/dual-bridge.asc

C1: cap; 1mF
D1: diode
D2: diode
D3: diode
D4: diode
D5: diode
D6: diode
D7: diode
D8: diode
R1: res; 1k
V1: voltage; SINE(0 25.2 50)
Named nets: 0
.tran 100ms
