dan-leo/digital-power-supply/schematic/.spice/negative700mV.asc

C1: cap; 10mF
D1: diode
D2: diode
D3: diode
D4: diode
D5: diode
Q1: npn
R1: res; 3
R2: res; 1k
R3: res; 10k
R4: res; 10
V1: voltage; SINE(0 25.2 50)
Named nets: Vneg, 0
.tran 2s
