dan-leo/digital-power-supply/schematic/.spice/negative_rail.asc

C1: cap; 470µ
C2: cap; 3m
C3: cap; 4.7mF; Rser=0.5
D1: schottky; DFLS220L
D2: schottky; DFLS220L
D3: schottky; DFLS220L
D4: schottky; DFLS220L
D5: diode
D6: diode
D7: zener; 1N752
R1: res; 30
R2: res; 1
R3: res; 320
R4: res; 100
V1: voltage; SINE(0 25.2 50); Rser=3
Named nets: 0
.tran 5
.ic V(N007)=-4
