dan-leo/digital-power-supply/schematic/digital-psu.brd

## EAGLE design schematic/digital-psu.brd (2016-10-11)

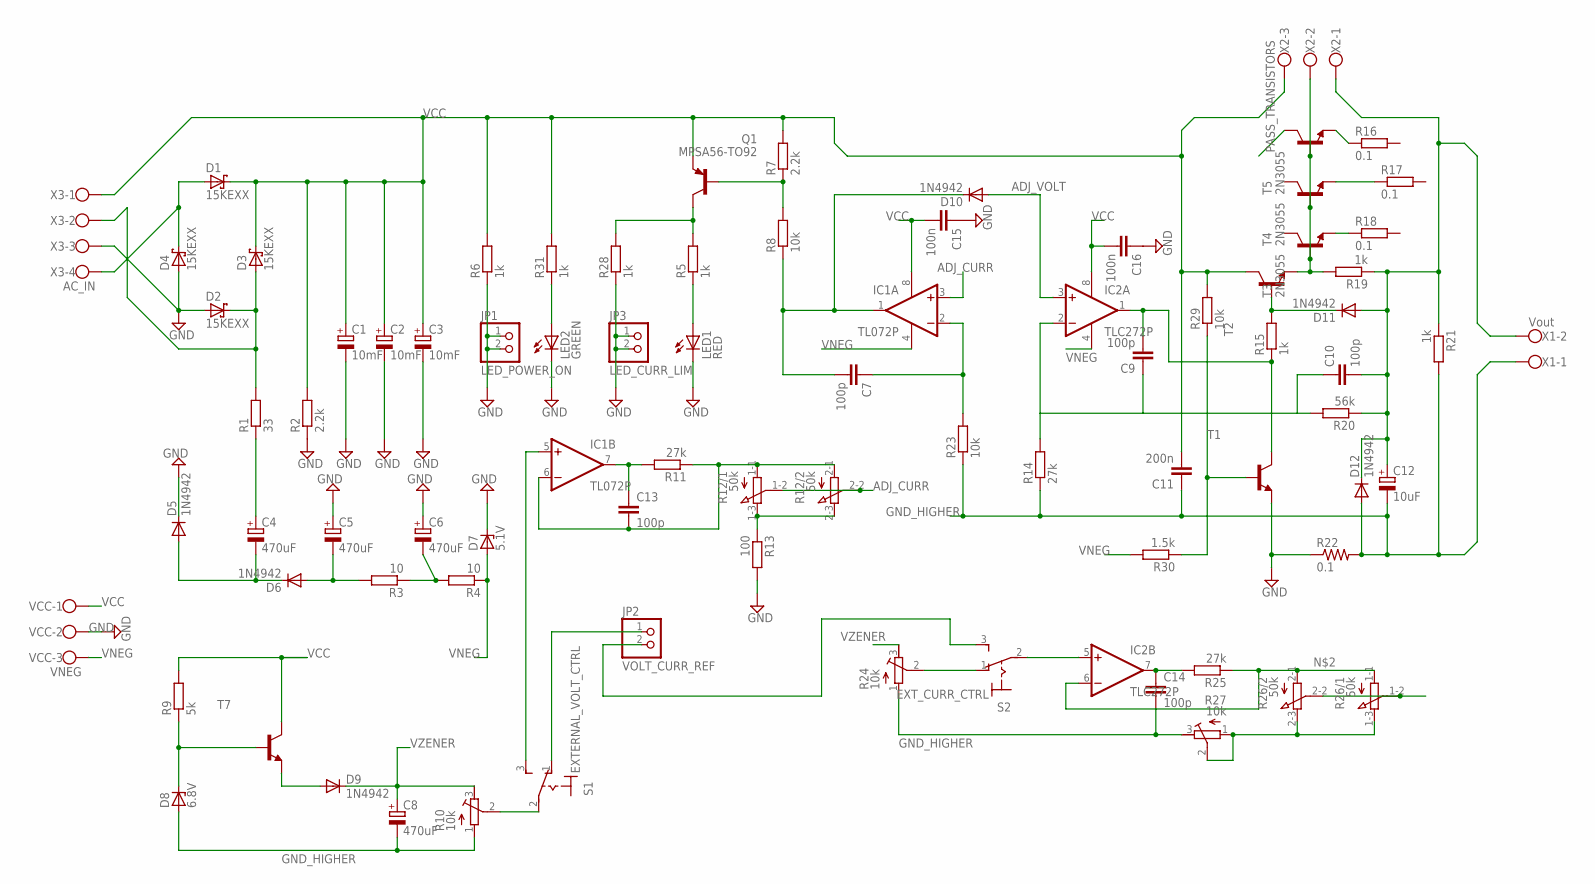
[picture p60: schematic digital-psu.sch]

Parts:
C1, C2, C3: 10mF; EB22,5D
C4, C5, C6, C8: 470uF; E5-10,5
C7, C9, C10, C13, C14: 100p; C0805
C11: 200n; C0805
C12: 10uF; E5-10,5
C15, C16: 100n; C0805
D1, D2, D3, D4: 15KEXX; CB429-17
D5, D6, D9, D10, D11, D12: 1N4942; DO41-10
D7: 5.1V; C1702-15
D8: 6.8V; C1702-15
IC1: TL072P; DIL08
IC2: TLC272P; DIL08
JP1: LED_POWER_ON; 1X02
JP2: VOLT_CURR_REF; 1X02
JP3: LED_CURR_LIM; 1X02
LED1: RED; LED5MM
LED2: GREEN; LED5MM
Q1: MPSA56-TO92; TO92-CBE
R1: 33; R0805
R2, R7: 2.2k; R0805
R3, R4: 10; R0805
R5, R6, R15, R19, R21, R28, R31: 1k; R0805
R8, R23, R29: 10k; R0805
R9: 5k; R0805
R10, R24, R27: 10k; RTRIM64W
R11, R14, R25: 27k; R0805
R12, R26: 50k; 3RP/1610G
R13: 100; R0805
R16, R17, R18: 0.1; VTA55
R20: 56k; R0805
R22: 0.1; VTA52
R30: 1.5k; R0805
S1: EXTERNAL_VOLT_CTRL; 320-916
S2: EXT_CURR_CTRL; 320-916
T1, T2, T7: -NPN-TO92-EBC; TO92-EBC
T3, T4, T5: 2N3055; TO3
VCC: VNEG; W237-103
X1: Vout; W237-113
X2: PASS_TRANSISTORS; W237-103
X3: AC_IN; W237-4

Connections:
ADJ_CURR: IC1.3 (+IN), R12.1-2 (S), R12.2-2 (S)
ADJ_VOLT: D10.A, IC2.3 (+IN), R26.1-2 (S), R26.2-2 (S)
GND: C1.-, C2.-, C3.-, C5.+, C6.+, C15.1, C16.1, D2.A, D4.A, D5.C, D7.C, JP1.1, JP1.2, JP3.1, JP3.2, LED1.K (C), LED2.K (C), R2.1, R6.1, R13.2, R22.1, R28.1, T1.E, VCC.2, X3.3
GND_HIGHER: C8.-, C11.1, C12.-, C14.2, D8.A, D12.A, R10.1 (A), R14.1, R21.2, R22.2, R23.1, R24.1 (A), R27.3 (E), X1.1
unnamed: D2.C, D3.A, R1.2, X3.2
unnamed: IC2.6 (-IN), R25.1, R26.1-1 (A), R26.2-1 (A)
unnamed: D1.A, D4.C, X3.4
unnamed: R10.2 (S), S1.2
unnamed: C4.-, D5.A, D6.C
unnamed: C5.-, D6.A, R3.2
unnamed: C6.-, R3.1, R4.2
unnamed: LED2.A, R31.1
unnamed: Q1.C, R5.2, R28.2
unnamed: LED1.A, R5.1
unnamed: Q1.B, R7.1, R8.2
unnamed: C7.2, D10.C, IC1.1 (OUT), R8.1
unnamed: D8.C, R9.1, T7.B
unnamed: R29.1, R30.1, T1.B
unnamed: C7.1, IC1.2 (-IN), R23.2
unnamed: D9.A, T7.E
unnamed: C13.2, IC1.6 (-IN), R11.1, R12.1-1 (A), R12.2-1 (A)
unnamed: JP2.2, S2.3 (S)
unnamed: C13.1, IC1.7 (OUT), R11.2
unnamed: R18.1, T3.E
unnamed: R17.1, T4.E
unnamed: R16.1, T5.E
unnamed: R19.2, T2.E, T3.B, T4.B, T5.B, X2.2
unnamed: D11.C, R15.2, T2.B
unnamed: R24.2 (S), S2.1 (O)
unnamed: C14.1, IC2.7 (OUT), R25.2
unnamed: C9.2, IC2.1 (OUT), R15.1, T1.C
unnamed: R12.1-3 (E), R12.2-3 (E), R13.1
unnamed: IC2.5 (+IN), S2.2
unnamed: C4.+, R1.1
unnamed: R26.1-3 (E), R26.2-3 (E), R27.1 (A), R27.2 (S)
unnamed: C9.1, C10.1, IC2.2 (-IN), R14.2, R20.2
unnamed: C10.2, C12.+, D11.A, D12.C, R19.1, R20.1, R21.1, X1.2, X2.1
unnamed: JP2.1, S1.1 (O)
unnamed: IC1.5 (+IN), S1.3 (S)
VCC: C1.+, C2.+, C3.+, C11.2, C15.2, C16.2, D1.C, D3.C, IC1.8 (V+), IC2.8 (V+), Q1.E, R2.2, R6.2, R7.2, R9.2, R29.2, R31.2, T2.C, T7.C, VCC.1, X2.3, X3.1
VNEG: D7.A, IC1.4 (V-), IC2.4 (V-), R4.1, R30.2, VCC.3
VZENER: C8.+, D9.C, R10.3 (E), R24.3 (E)

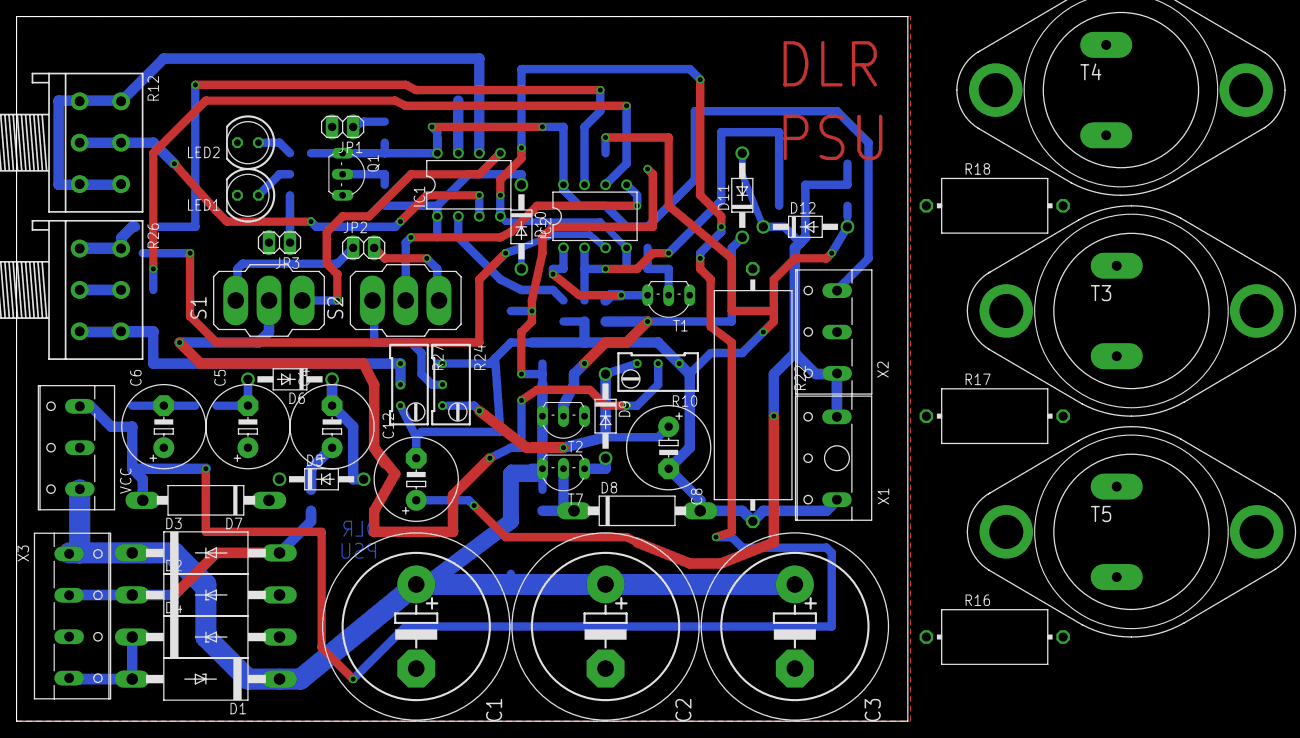
[picture p61: board digital-psu.brd from above]

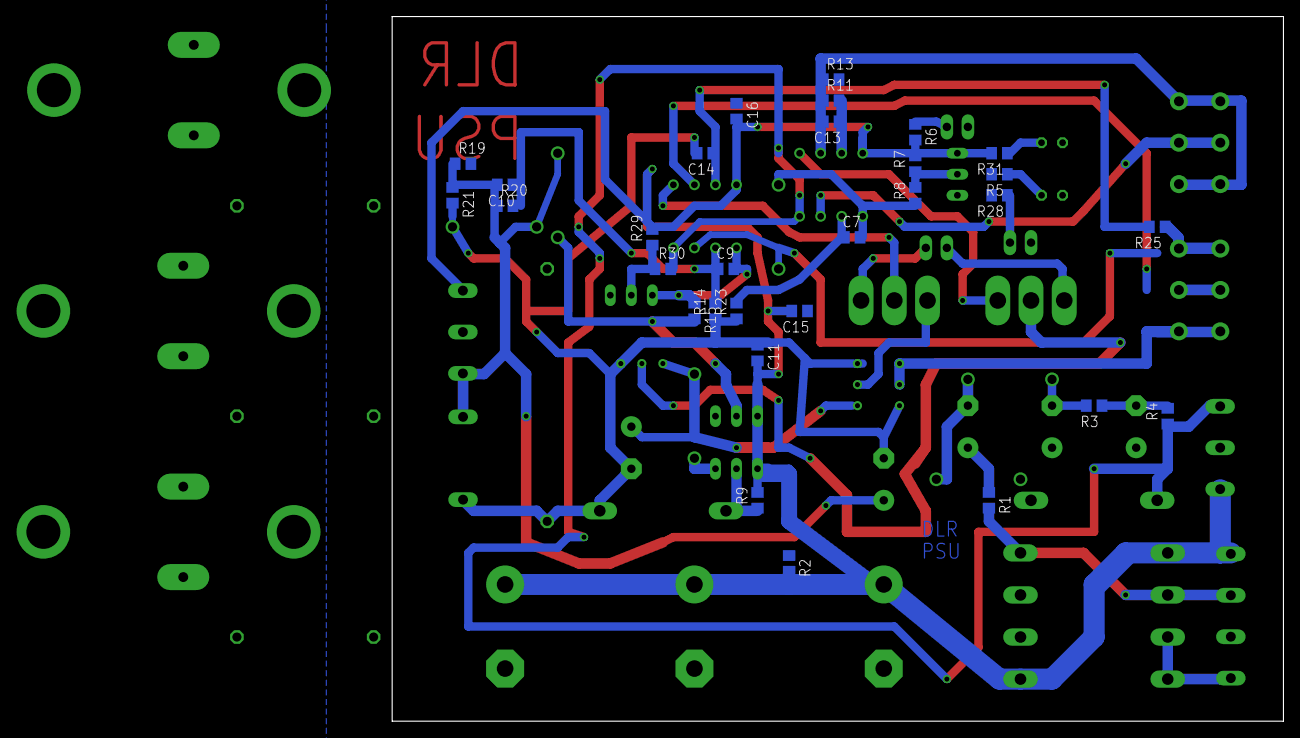
[picture p62: board digital-psu.brd from below]

Board: 2 copper layers, 107.6 x 85.1 mm, 79 parts (30 on the bottom side), 42 nets.
