dan-leo/digital-power-supply/schematic/eagle/current_sensor.brd

## EAGLE design schematic/eagle/current_sensor.brd (2016-10-03)

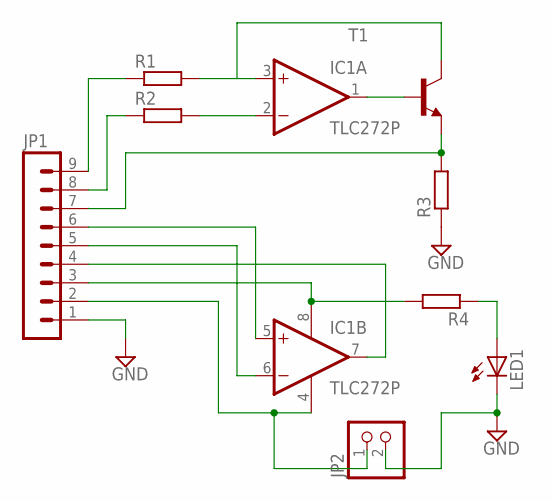
[picture p63: schematic current_sensor.sch]

Parts:
IC1: TLC272P; DIL08
JP1: MA09-1
JP2: PINHD-1X2; 1X02
LED1: LEDCHIP-LED0805; CHIP-LED0805
R1, R2, R3, R4: R; R0805
T1: BF422-NPN-TO92-BCE; TO92-BCE

Connections:
GND: JP1.1, JP2.2, LED1.C, R3.1
unnamed: JP1.7, R3.2, T1.E
unnamed: IC1.1 (OUT), T1.B
unnamed: IC1.2 (-IN), R2.2
unnamed: IC1.3 (+IN), R1.2, T1.C
unnamed: JP1.9, R1.1
unnamed: JP1.8, R2.1
unnamed: LED1.A, R4.1
unnamed: IC1.5 (+IN), JP1.6
unnamed: IC1.6 (-IN), JP1.5
unnamed: IC1.7 (OUT), JP1.4
unnamed: IC1.4 (V-), JP1.2, JP2.1
unnamed: IC1.8 (V+), JP1.3, R4.2

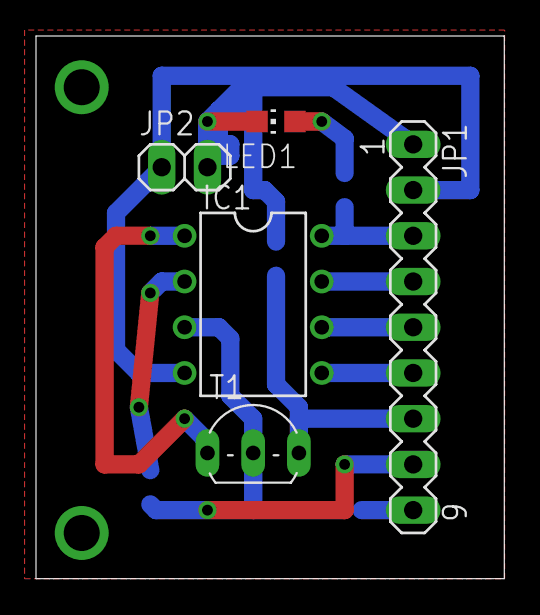
[picture p64: board current_sensor.brd from above]

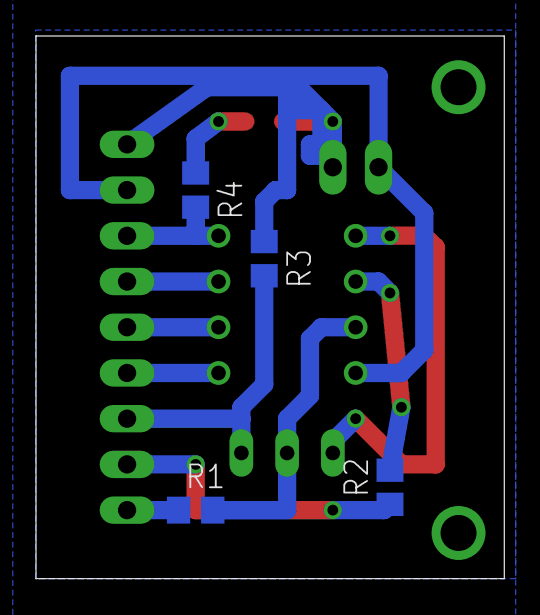
[picture p65: board current_sensor.brd from below]

Board: 2 copper layers, 26.0 x 30.1 mm, 9 parts (4 on the bottom side), 13 nets.
