dan-leo/digital-power-supply/code/system/pins.h

/*
 * pins.h
 *
 *  Created on: 15 Jul 2016
 *      Author: Daniel
 */

#ifndef SYSTEM_PINS_H_
#define SYSTEM_PINS_H_

#define led_builtin 13
#define led_white 8

#define PIN_SCE   7
#define PIN_RESET 6
#define PIN_DC    5
#define PIN_SDIN  4
#define PIN_SCLK  3



#endif /* SYSTEM_PINS_H_ */
