dan-leo/digital-power-supply/code/.ino.cpp

#ifdef __IN_ECLIPSE__
//This is a automatic generated file
//Please do not modify this file
//If you touch this file your change will be overwritten during the next build
//This file has been generated on 2016-07-27 18:43:21

#include "Arduino.h"
#include "Arduino.h"
#include "system/nokia_lcd.h"
#include "system/pins.h"
#include "timer/TimerOne.h"
void setup() ;
void loop() ;
void callback() ;

#include "digital_power_supply.ino"


#endif
