dan-leo/digital-power-supply/(commit log)

2016-07-20 added test code {leds, nokia lcd, serial}
2016-07-20 added timer lib, pwm not working
    [.ino.cpp, TimerOne.cpp, digital_power_supply.ino]
2016-07-26 added python test code (to be implemented), pwm code (stuck on 50% duty cycle)
    [.ino.cpp, TimerOne.cpp, digital_power_supply.ino]
2016-07-27 using 1.1V internal voltage reference for analogue signals
2016-08-08 added schematic
2016-08-08 low side current sensing
2016-08-09 simulating constant current
2016-08-10 low side current sensing does not affect output voltage
2016-08-23 updated schematic: too complex for ltspice in one go ~ chunks should be simulated separately
2016-08-23 updated schematic: steady op amp supply
2016-08-23 updated schematic
2016-09-11 stabilising spice circuit
2016-09-13 still trying to stabilise current limiting
2016-09-14 current limiting much more stable, op amp outputs more gentle
2016-09-17 removed sub test voltage regulator circuit influencing current sensing
2016-09-17 last design before moving to high-side current sensing. Was sensing large capacitive loads through current shunt
2016-09-18 added fold-back current limiting and high side current sensing
2016-09-18 trying to dampen the 'increase current' response
2016-09-19 current response much quicker now, added clever arrangement with diodes. Good response for load greater than 1 ohm so far
2016-09-20 removed resistor from Vcc to base of darlington pair
2016-09-20 circuit responds just about perfectly to impulses!
2016-09-22 precursor to using diode to pull voltage adjust line down
2016-09-23 added v2 spice of power supply. Very stable zener reference. Current limiting works with 10mohm short
2016-09-24 much has been done. Built negative voltage pump. Working out which ground rail to use.
2016-09-27 added eagle schematic and started board layout
    [digital-psu.brd, digital-psu.sch]
2016-09-27 laying traces for PCB
    [digital-psu.brd, digital-psu.sch]
2016-09-28 routing board 85% from completion
    [digital-psu.brd, digital-psu.sch]
2016-09-28 finished routing board
    [digital-psu.brd, digital-psu.sch]
2016-09-28 adjusted spacing between traces, added ground plane bottom and copper polygon on top
    [digital-psu.brd]
2016-09-28 created gerber files
    [digital-psu.brd, digital-psu.sch]
2016-09-29 gerber files
    [digital-psu.brd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]
2016-10-01 fixed a few small errors
    [digital-psu.sch]
2016-10-02 fixed op amp output errors
    [digital-psu.sch]
2016-10-02 removed all airwires
    [digital-psu.brd, digital-psu.sch]
2016-10-02 op amp 27k protection fixed
    [digital-psu.brd, digital-psu.sch]
2016-10-03 added .spice files. In process of joining the two separate grounds
    [_saved_digital-power-supply.sch, digital-power-supply.kicad_pcb, digital-power-supply.sch, digital-psu.brd, digital-psu.sch]
2016-10-03 developed common-mode extending current sensor daughter board eagle + gerbers
    [current_sensor.brd, current_sensor.sch, digital-psu.brd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]
2016-10-11 added spice: dac, negative transformer, zener etc, and initial arduino uno code
    [digital-psu.brd, digital-psu.sch]
2016-10-11 fixed PWM not working. Some compilers do not 'see' analogWrite if nested too deeply
    [firmware.ino]
2016-10-21 report: added schematic
2016-10-23 battery charging + cellular connectivity
